GurshanRiarh/INSTRUMENTED-INFANT-CHILD-CAR-SEAT/docs/system-architecture.pdf

## Instrumented Infant-Child Car Seat - Data Path

Research prototype. V1 is the thesis reproduction; V3 is the modular sensor upgrade.

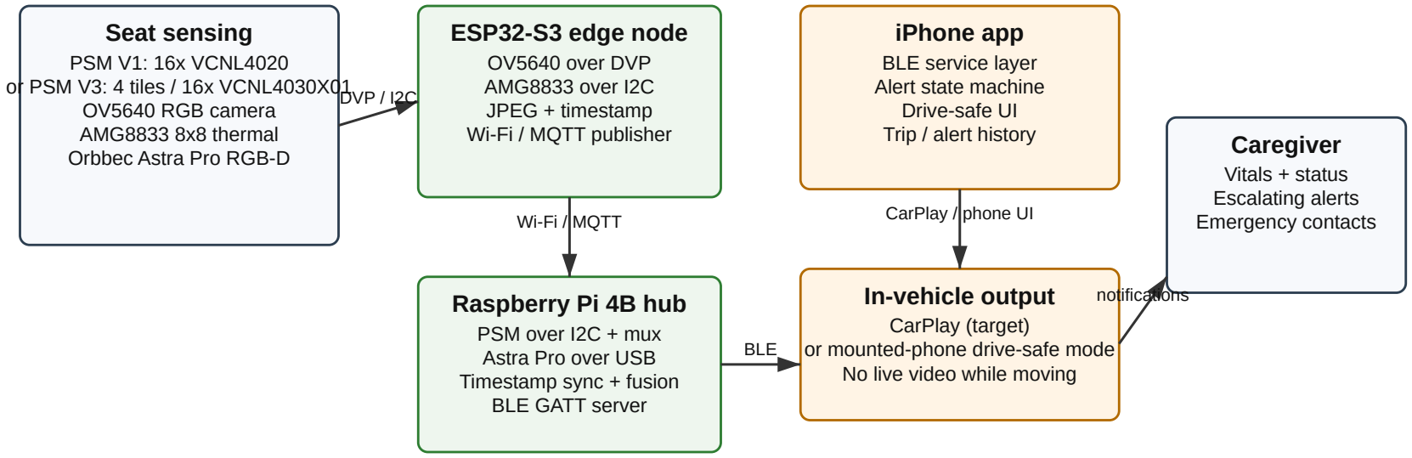
[picture p8: figure]
Seat sensing PSM V1: 16x VCNL4020 or PSM V3: 4 tiles / 16x VCNL4030X01 OV5640 RGB camera AMG8833 8x8 thermal Orbbec Astra Pro RGB-D; ESP32-S3 edge node OV5640 over DVP AMG8833 over I2C JPEG + timestamp Wi-Fi / MQTT publisher; Raspberry Pi 4B hub PSM over I2C + mux Astra Pro over USB Timestamp sync + fusion BLE GATT server; iPhone app BLE service layer Alert state machine Drive-safe UI Trip / alert history; In-vehicle output CarPlay (target) or mounted-phone drive-safe mode No live video while moving; Caregiver Vitals + status Escalating alerts Emergency contacts; DVP / I2C; Wi-Fi / MQTT; BLE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

### Design note

The Pi owns acquisition and fusion. The phone owns the alert state machine and escalation. The PSM is not a certified medical device. V1 uses two PCA9548A muxes (0x70/0x71) for 16 VCNL4020 sensors. V3 uses one PCA9548A (0x70) for up to 8 tiles.
