GurshanRiarh/INSTRUMENTED-INFANT-CHILD-CAR-SEAT/docs/psm-v1-architecture.pdf

## PSM V1 - Electrical Architecture (thesis baseline)

16x Vishay VCNL4020 (fixed 7-bit address 0x13), 2x PCA9548A 8-channel I2C switch, Tiva/LaunchPad header.

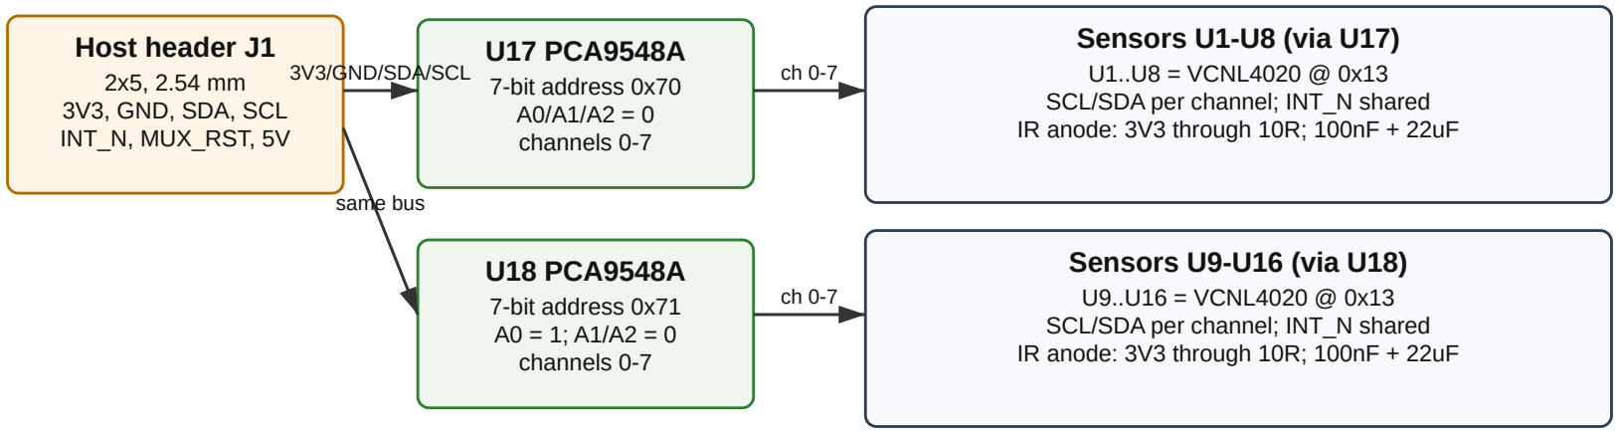
[picture p9: figure]
Host header J1 2x5, 2.54 mm 3V3, GND, SDA, SCL INT_N, MUX_RST, 5V; U17 PCA9548A 7-bit address 0x70 A0/A1/A2 = 0 channels 0-7; U18 PCA9548A 7-bit address 0x71 A0 = 1; A1/A2 = 0 channels 0-7; Sensors U1-U8 (via U17) U1..U8 = VCNL4020 @ 0x13 SCL/SDA per channel; INT_N shared IR anode: 3V3 through 10R; 100nF + 22uF; Sensors U9-U16 (via U18) U9..U16 = VCNL4020 @ 0x13 SCL/SDA per channel; INT_N shared IR anode: 3V3 through 10R; 100nF + 22uF; 3V3/GND/SDA/SCL; same bus

### Channel map

U17 ch0..7 -> U1..U8 U18 ch0..7 -> U9..U16
Each VCNL4020: 1 IR anode, 2 SDA, 3 INT, 4 SCL, 5 VDD, 8/9 GND, 6/7/10 NC.
Pull-ups: 4.7k on upstream SDA/SCL; 10k on MUX_RST and INT_N. 22uF bulk + 100nF per sensor. Board: 101.6 x 101.6 mm, 4x4 grid at 25.4 mm pitch, 0.2 mm polyimide flex, 2 layers.
