GurshanRiarh/INSTRUMENTED-INFANT-CHILD-CAR-SEAT/docs/psm-v3-topology.pdf

## PSM V3 - Modular Tile Topology (Prannav improvements)

One mux, four 2x2 tiles, four factory I2C addresses per tile. Expandable to 8 tiles / 32 sensors.

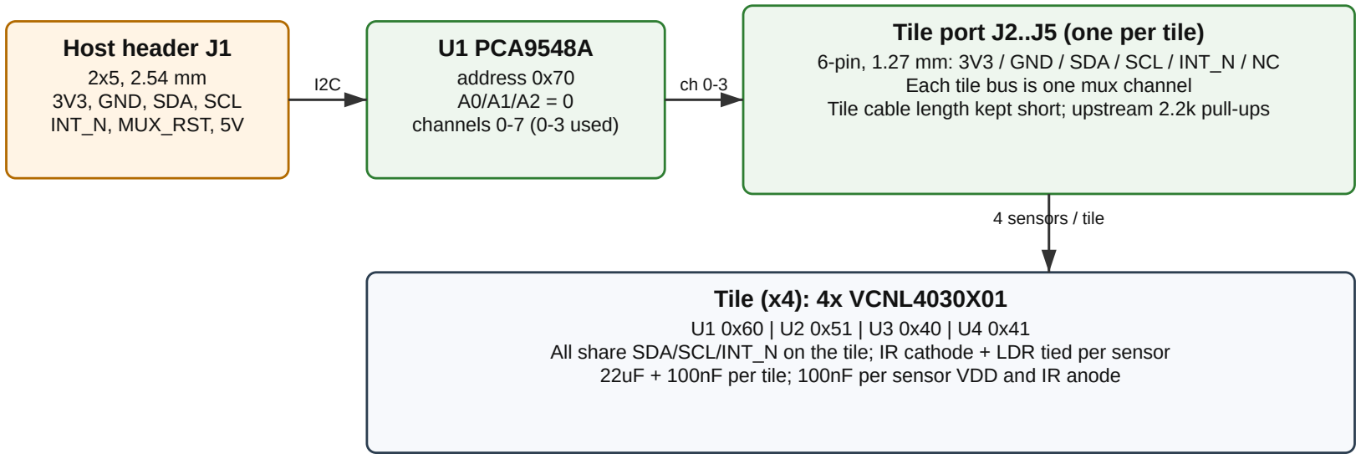
[picture p10: figure]
Host header J1 2x5, 2.54 mm 3V3, GND, SDA, SCL INT_N, MUX_RST, 5V; U1 PCA9548A address 0x70 A0/A1/A2 = 0 channels 0-7 (0-3 used); Tile port J2..J5 (one per tile); Each tile bus is one mux channel; Tile (x4): 4x VCNL4030X01 U1 0x60 | U2 0x51 | U3 0x40 | U4 0x41; 4 sensors / tile

6-pin, 1.27 mm: 3V3 / GND / SDA / SCL / INT_N / NC

Tile cable length kept short; upstream 2.2k pull-ups

All share SDA/SCL/INT_N on the tile; IR cathode + LDR tied per sensor 22uF + 100nF per tile; 100nF per sensor VDD and IR anode

### Why this is an improvement

V1: 2 muxes, 16 channels, fixed 0x13 sensors. V3: 1 mux, 4 channels, four addresses per tile. Tiles can be placed on the car-seat contour and replaced individually; the hub supports up to 8 tiles. Tile: 30 x 30 mm, 0.2 mm flex, sealing ring + conformal coat. Hub: 60 x 40 mm, 1.6 mm FR4.
