GurshanRiarh/INSTRUMENTED-INFANT-CHILD-CAR-SEAT/docs/psm-v1-architecture.png

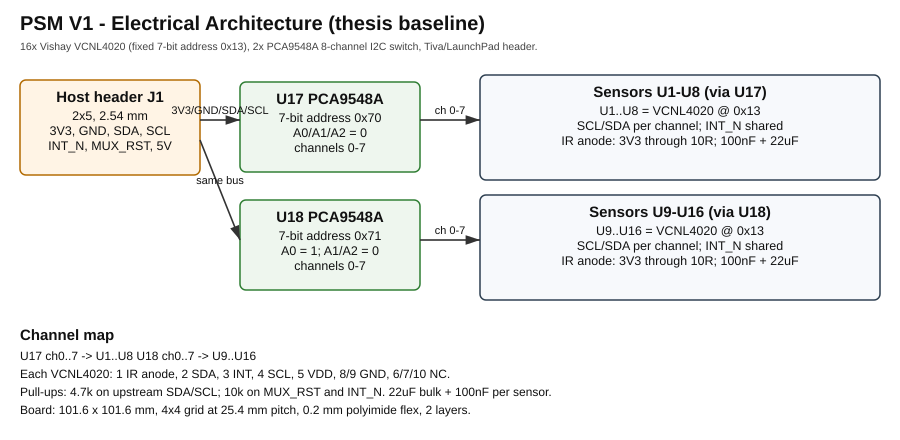
docs/psm-v1-architecture.png
