GurshanRiarh/INSTRUMENTED-INFANT-CHILD-CAR-SEAT/docs/psm-v1-schematic.png

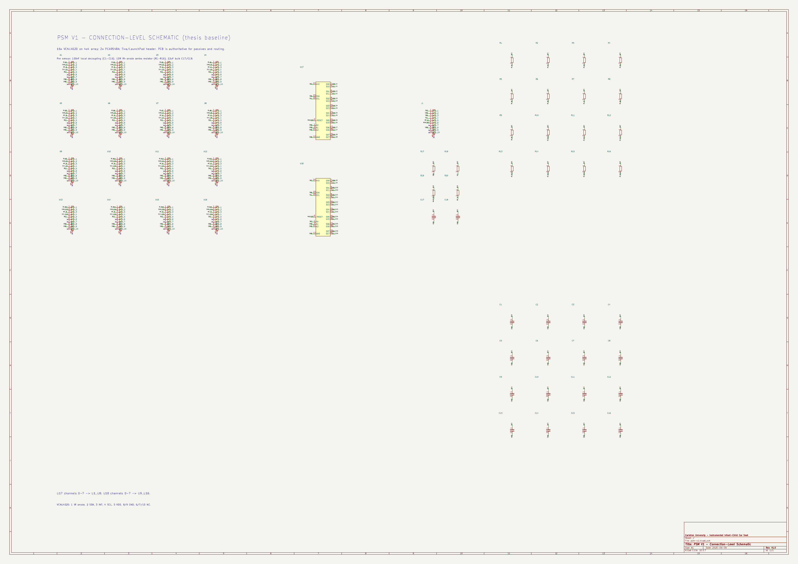
docs/psm-v1-schematic.png
