GurshanRiarh/INSTRUMENTED-INFANT-CHILD-CAR-SEAT/hardware/psm-v3/tile/bom.csv

Quantity | References | Value | Footprint
8 | C1 C2 C3 C4 C5 C6 C7 C8 | 100n | C_0603_1608Metric
3 | R1 R2 R3 | 10k | R_0603_1608Metric
1 | C9 | 22u | C_0805_2012Metric
4 | H1 H2 H3 H4 | M2 | MountingHole_2.2mm_M2
1 | J1 | TILE_IF | PinHeader_1x06_P1.27mm_Vertical
1 | U3 | VCNL4030X01 0x40 | VCNL4030X01
1 | U4 | VCNL4030X01 0x41 | VCNL4030X01
1 | U2 | VCNL4030X01 0x51 | VCNL4030X01
1 | U1 | VCNL4030X01 0x60 | VCNL4030X01
