GurshanRiarh/INSTRUMENTED-INFANT-CHILD-CAR-SEAT/docs/psm-v1-schematic.pdf

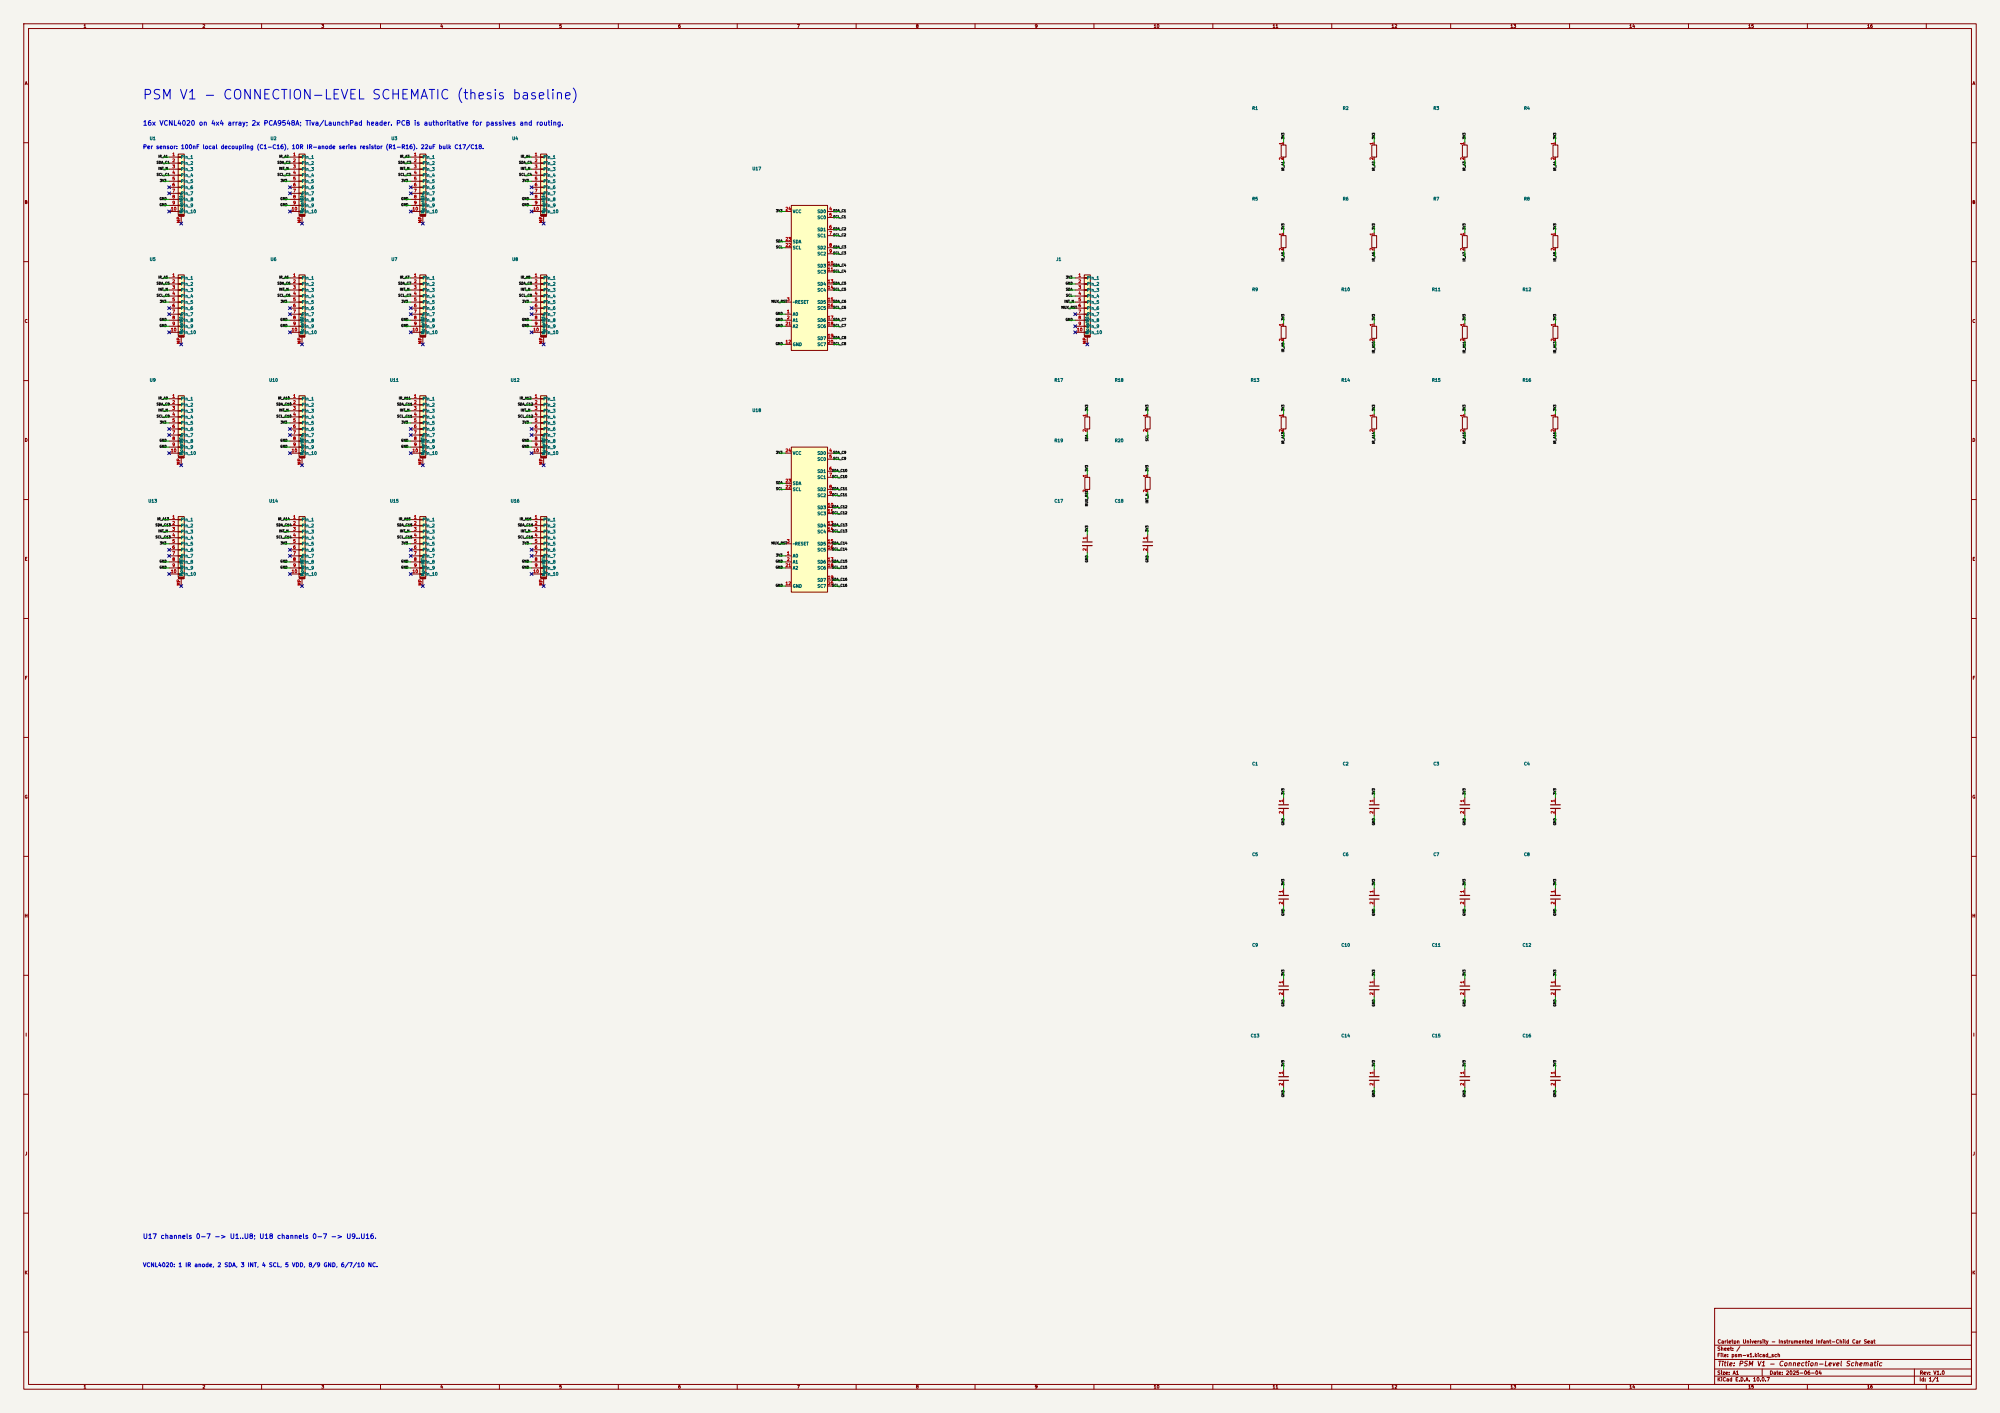
[picture p13: page 1]

PSM V1 - CONNECTION-LEVEL SCHEMATIC (thesis baseline)

16x VCNL4020 on 4x4 array; 2x PCA9548A; Tiva/LaunchPad header. PCB is authoritative for passives and routing.

Per sensor: 100nF local decoupling (C1-C16), 10R IR-anode series resistor (R1-R16). 22uF bulk C17/C18.

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

Carleton University - Instrumented Infant-Child Car Seat
Sheet: /
File: psm-v1.kicad_sch
Title: PSM V1 - Connection-Level Schematic

Size: A1 | Rev: V1.0
KiCad E.D.A. 10.0.7 | Id: 1/1
