GurshanRiarh/INSTRUMENTED-INFANT-CHILD-CAR-SEAT/docs/psm-v3-hub-schematic.pdf

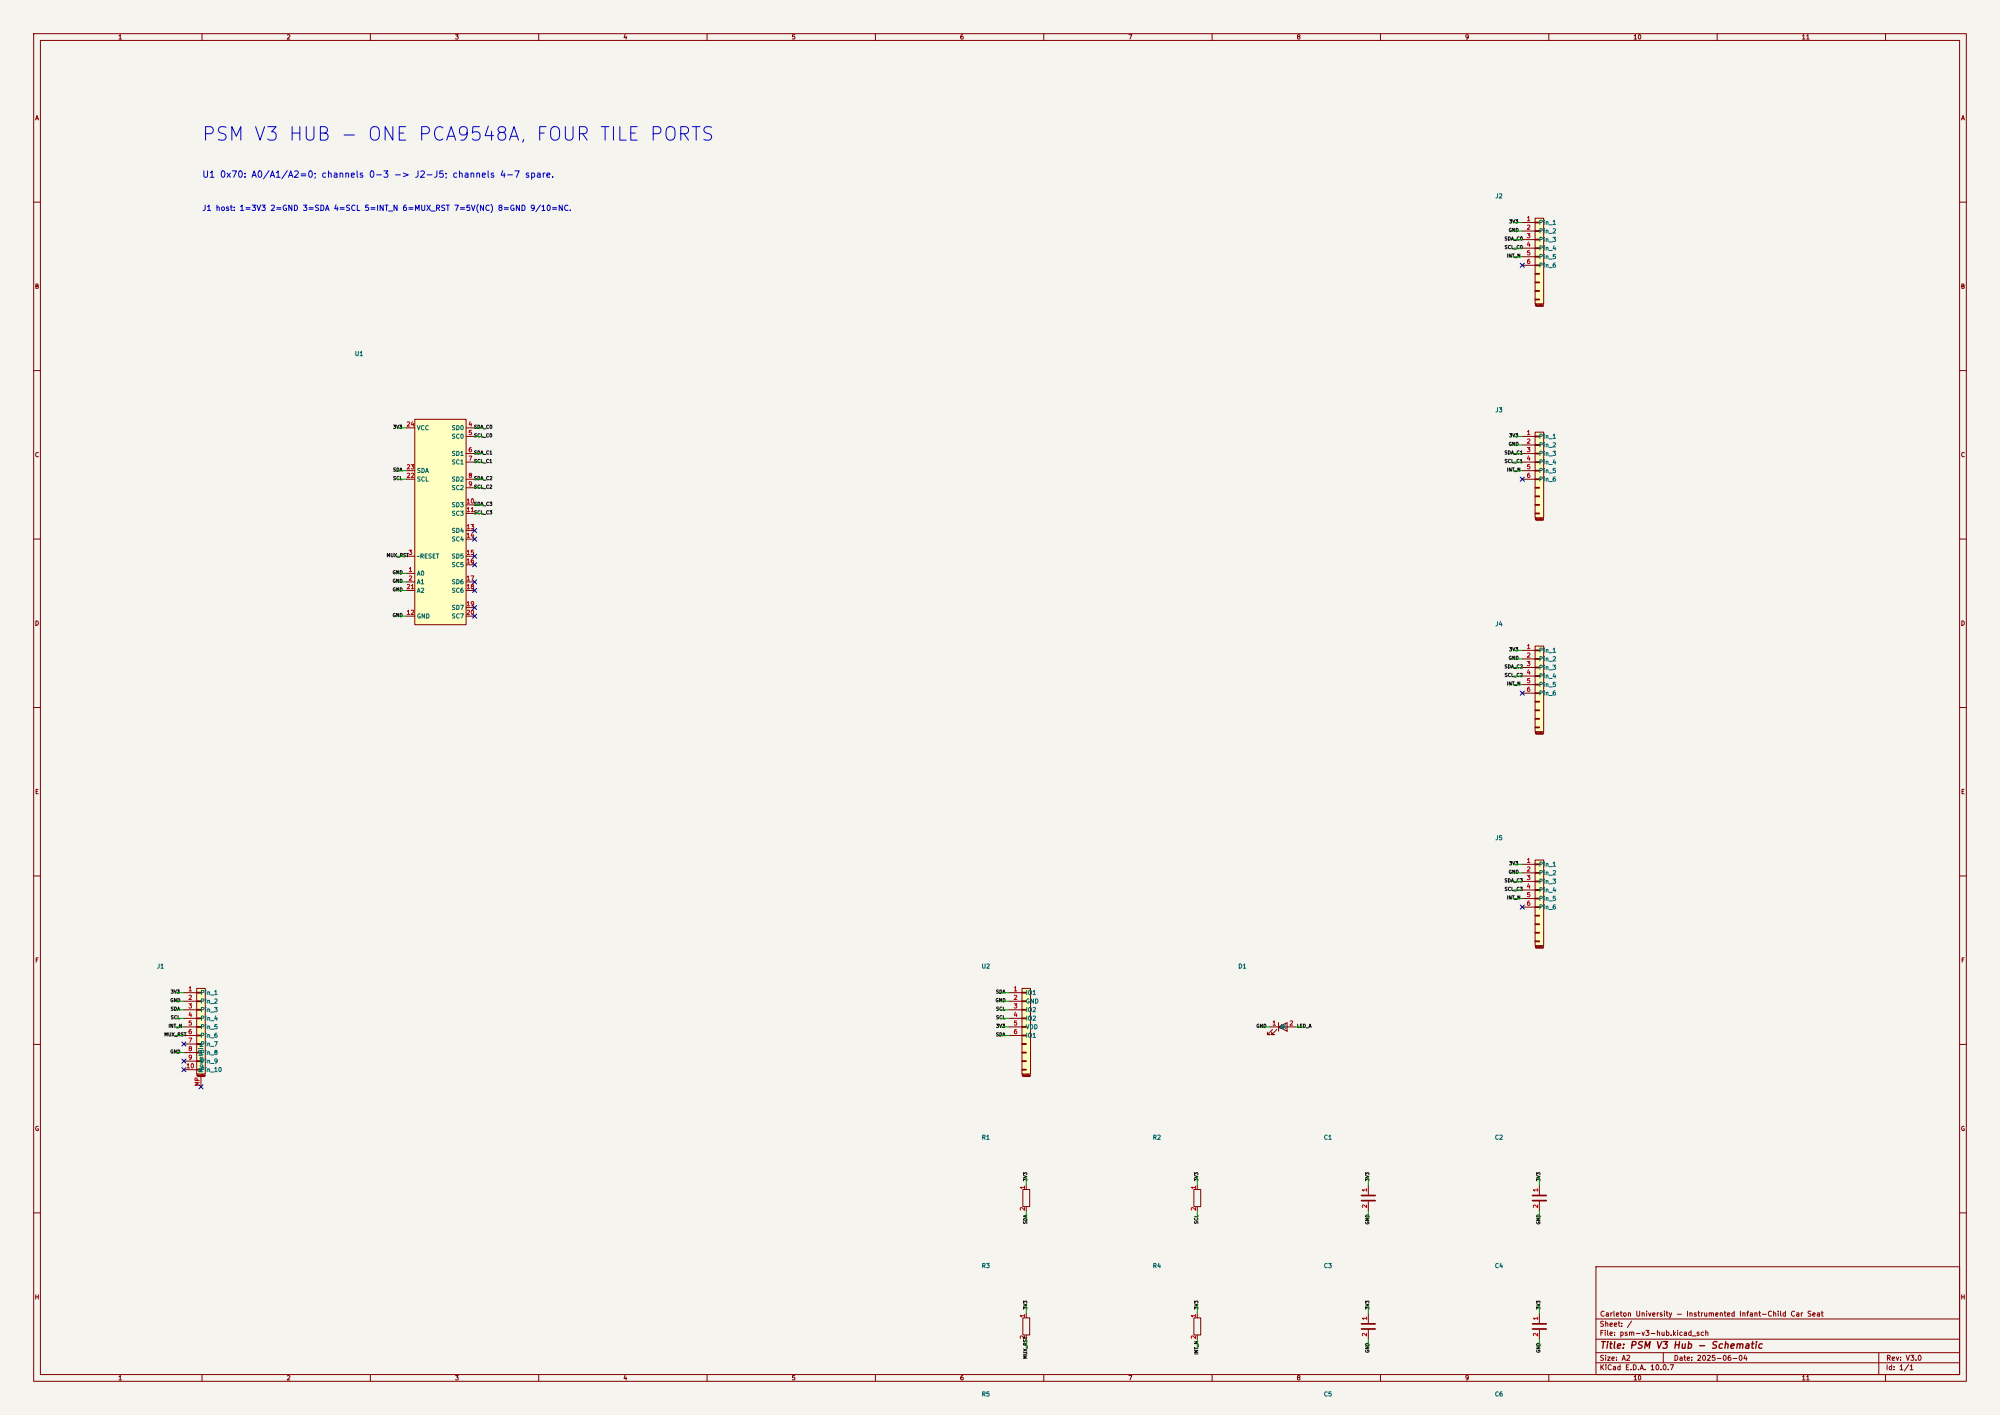
[picture p14: page 1]

PSM V3 HUB - ONE PCA9548A, FOUR TILE PORTS

J1 host: 1=3V3 2=GND 3=SDA 4=SCL 5=INT_N 6=MUX_RST 7=5V(NC) 8=GND 9/10=NC.

Carleton University - Instrumented Infant-Child Car Seat 1 2 C5

Sheet: /
File: psm-v3-hub.kicad_sch
Title: PSM V3 Hub - Schematic

Size: A2 | Rev: V3.0
KiCad E.D.A. 10.0.7 | Id: 1/1
