GurshanRiarh/INSTRUMENTED-INFANT-CHILD-CAR-SEAT/docs/psm-v3-tile-schematic.pdf

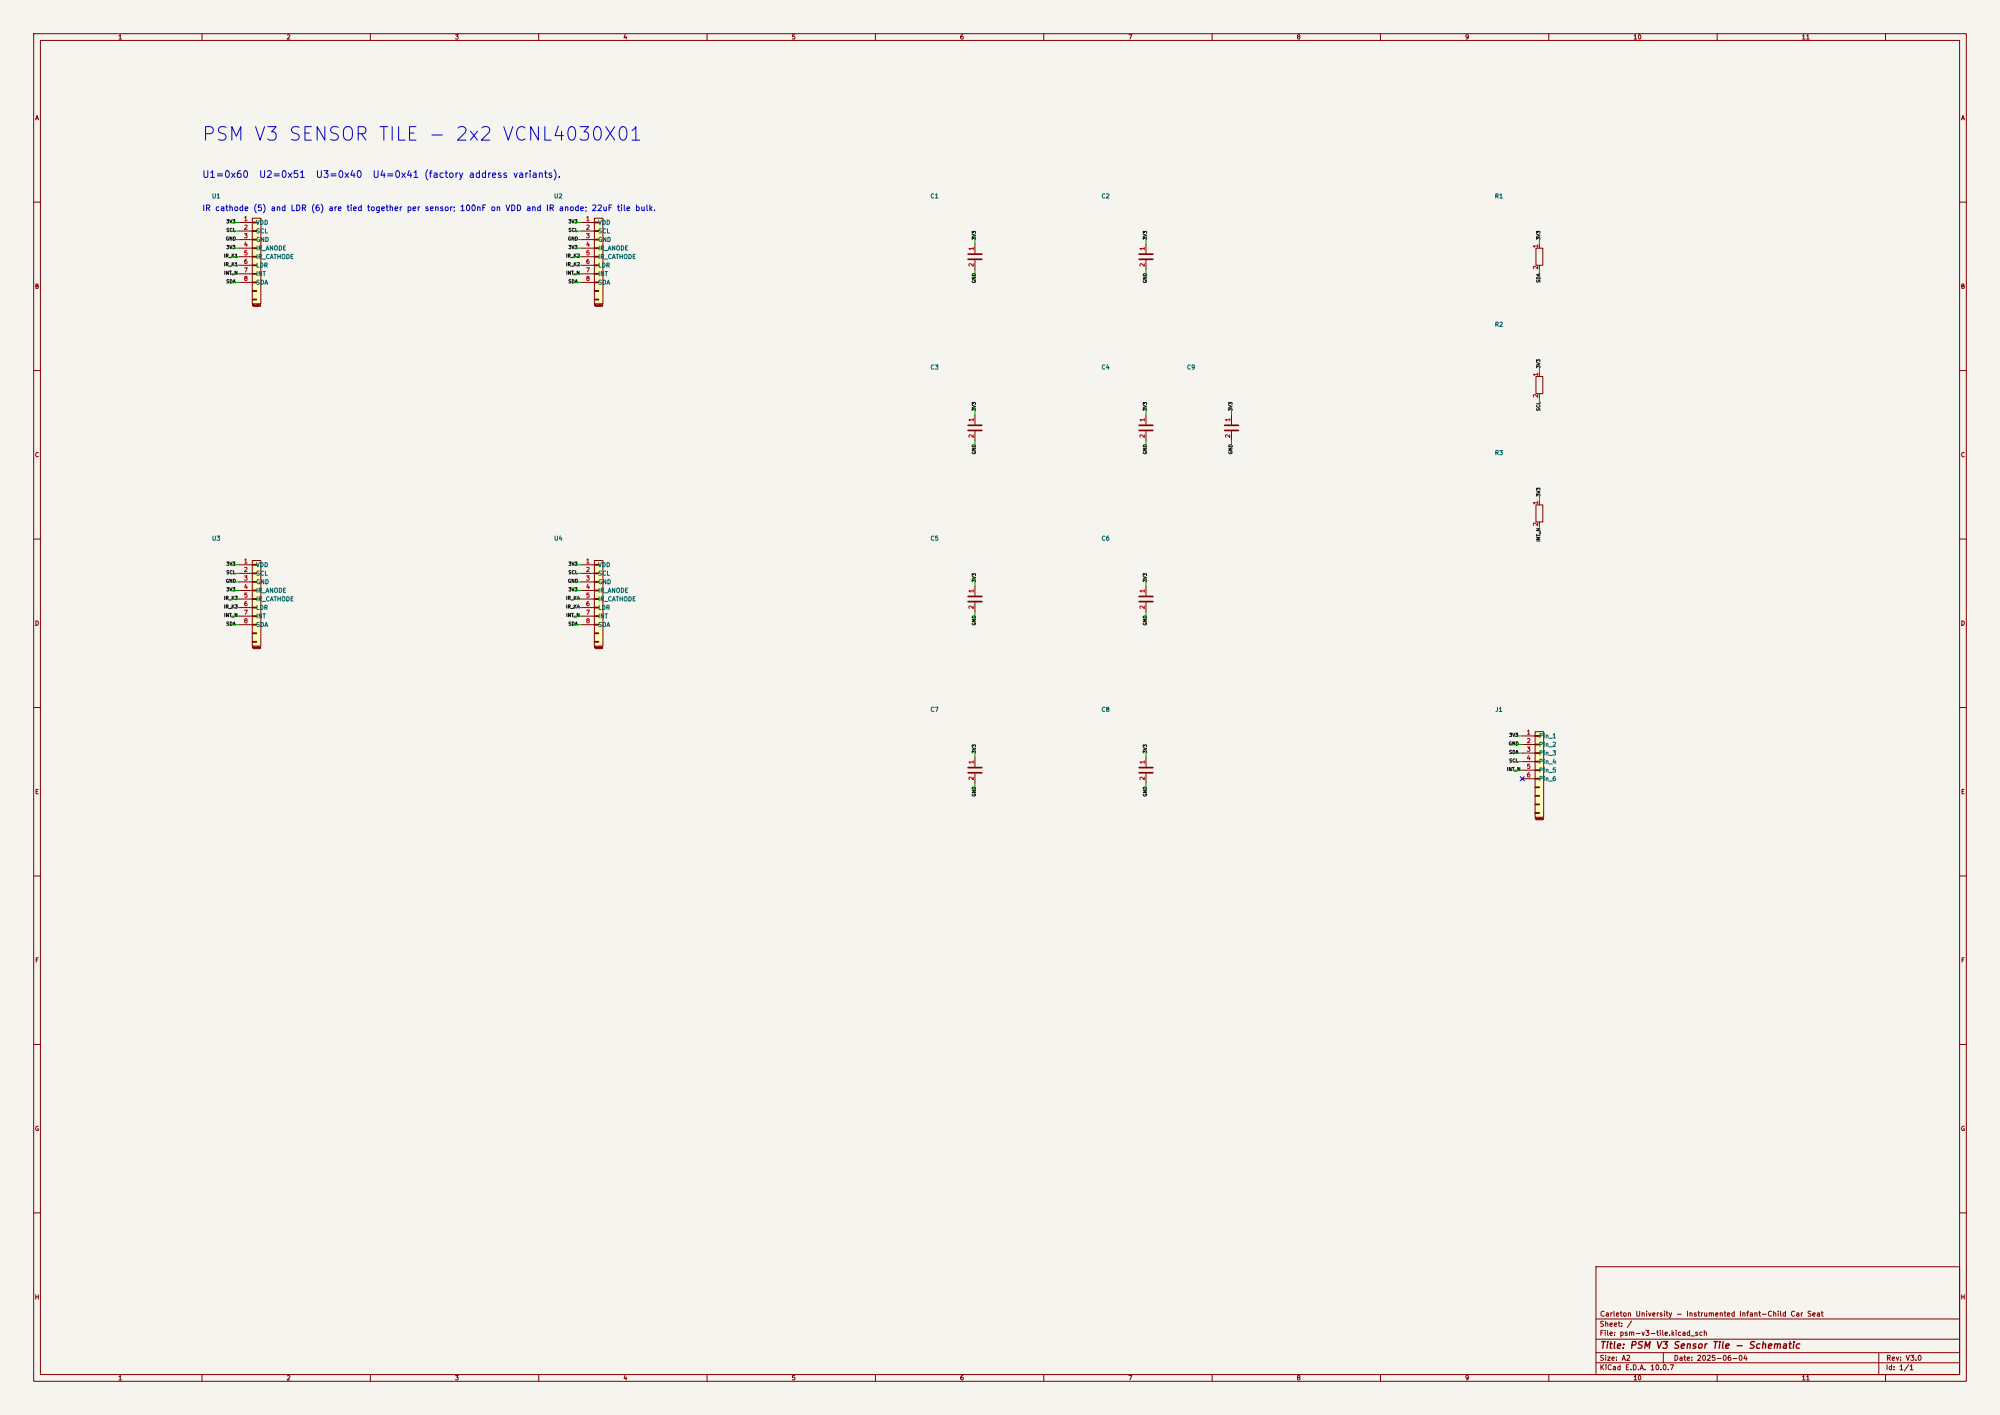
[picture p15: page 1]

SDA PSM V3 SENSOR TILE - 2x2 VCNL4030X01

SDA 8 U1
IR cathode (5) and LDR (6) are tied together per sensor; 100nF on VDD and IR anode; 22uF tile bulk.

Carleton University - Instrumented Infant-Child Car Seat
Sheet: /
File: psm-v3-tile.kicad_sch
Title: PSM V3 Sensor Tile - Schematic

Size: A2 | Rev: V3.0
KiCad E.D.A. 10.0.7 | Id: 1/1
