GurshanRiarh/INSTRUMENTED-INFANT-CHILD-CAR-SEAT/hardware/psm-v3/hub/fab/psm-v3-hub.pdf

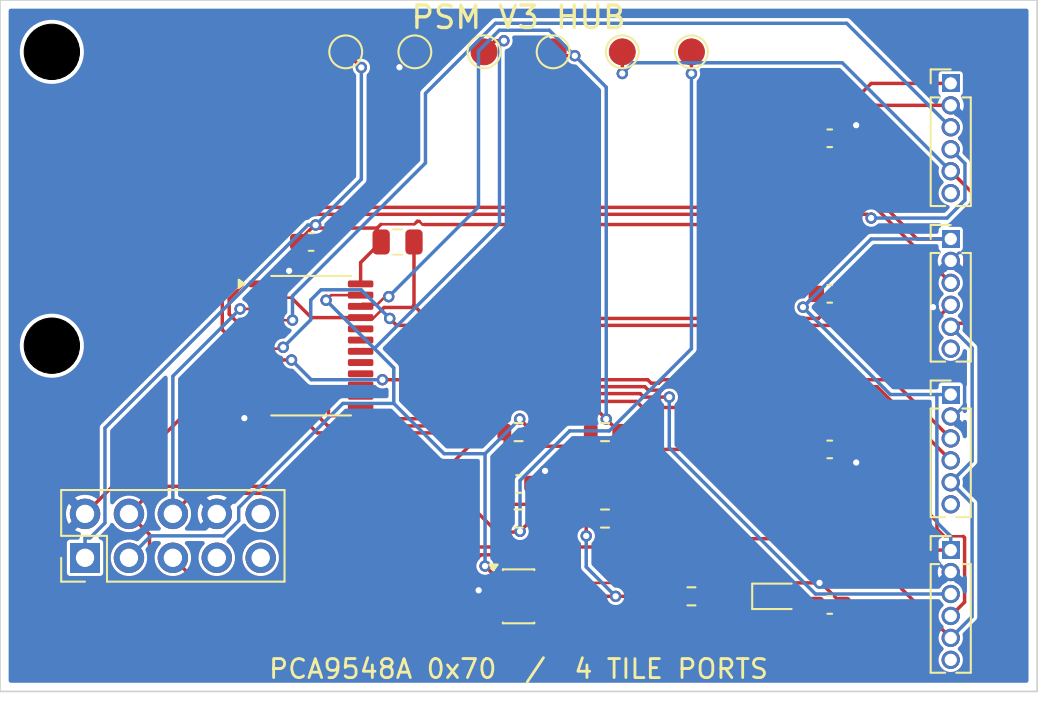
[picture p16: page 1]

PCA9548A 0x70 / 4 TILE PORTS PSM V3 HUB
