GurshanRiarh/INSTRUMENTED-INFANT-CHILD-CAR-SEAT/hardware/psm-v3/tile/fab/psm-v3-tile.pdf

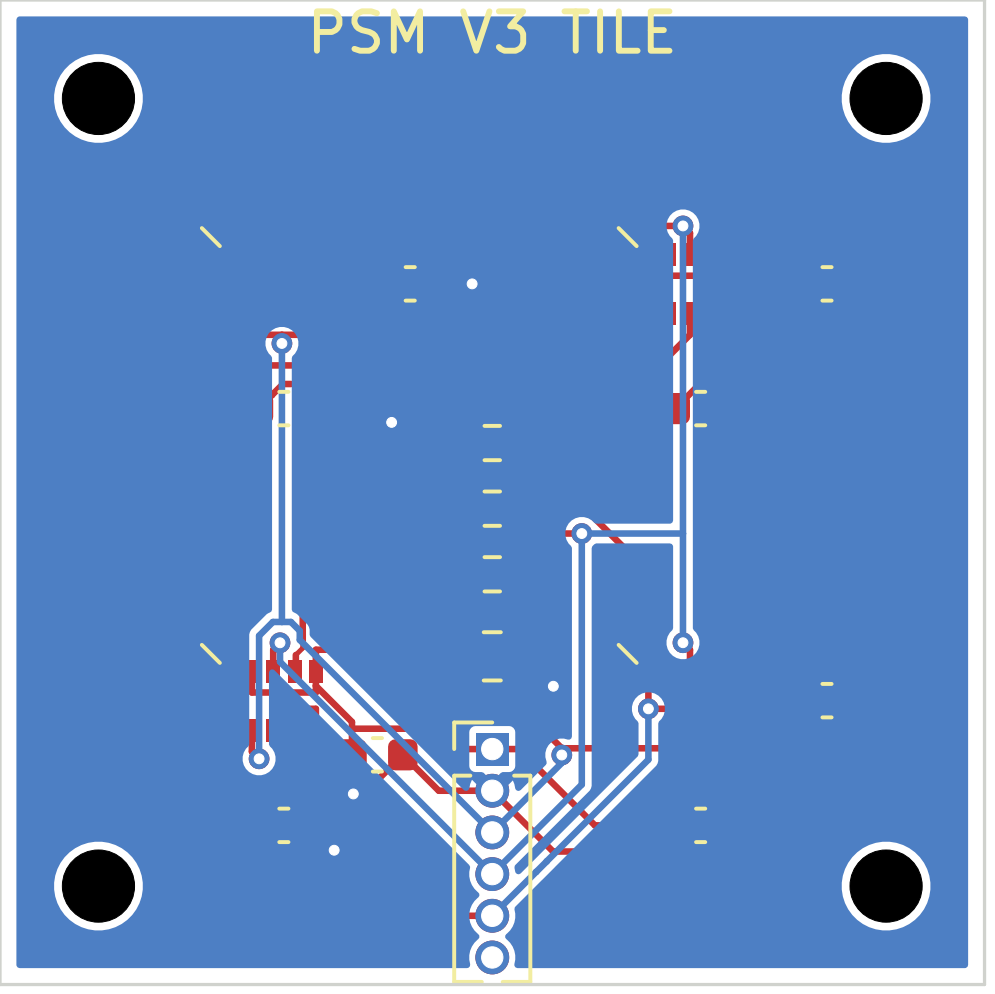
[picture p17: page 1]
