GurshanRiarh/INSTRUMENTED-INFANT-CHILD-CAR-SEAT/hardware/psm-v1/fab/psm-v1.pdf

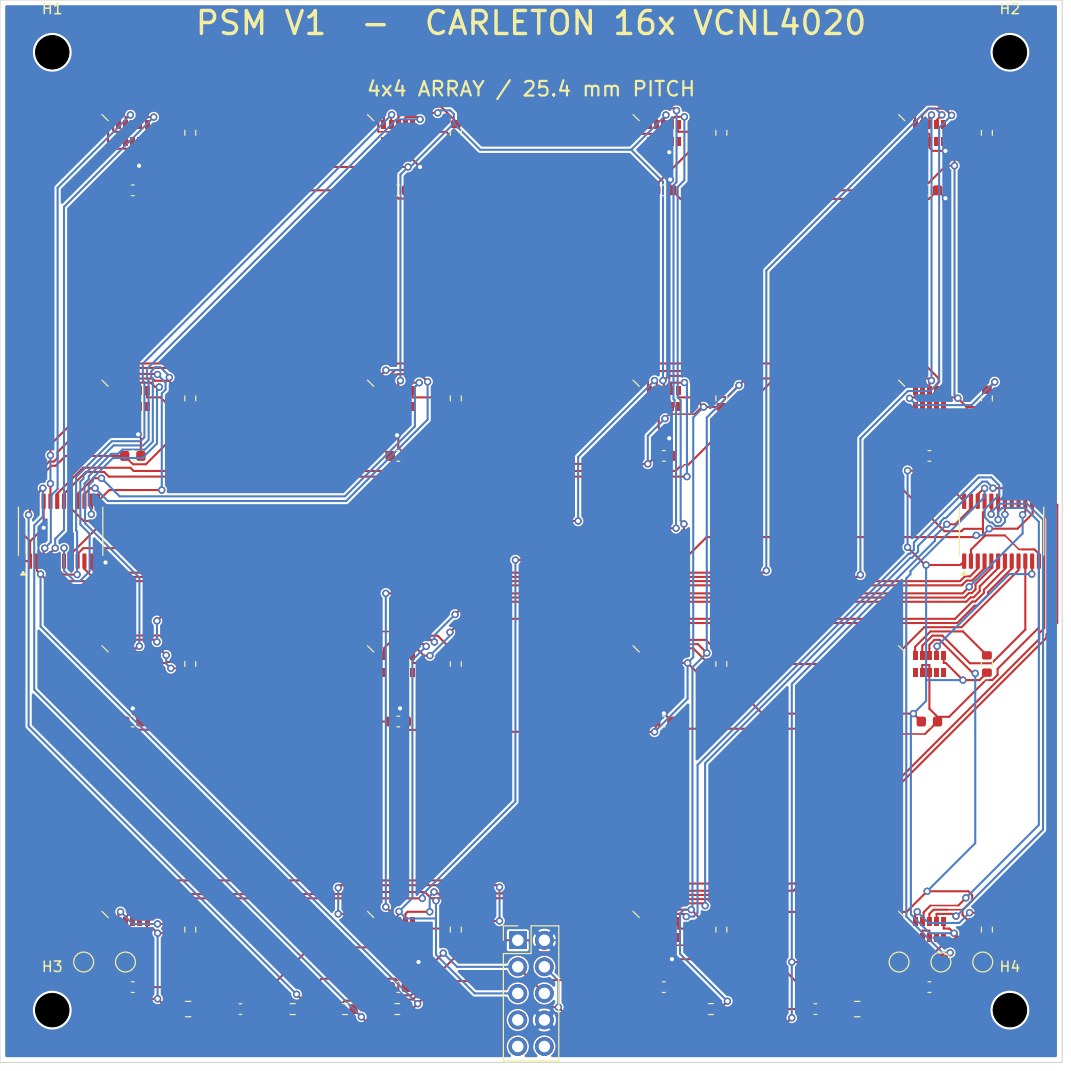
[picture p18: page 1]
