GurshanRiarh/INSTRUMENTED-INFANT-CHILD-CAR-SEAT/hardware/psm-v1/psm-v1.kicad_pcb

## KiCad design hardware/psm-v1/psm-v1.kicad_pcb (2026-10-25, an earlier design)

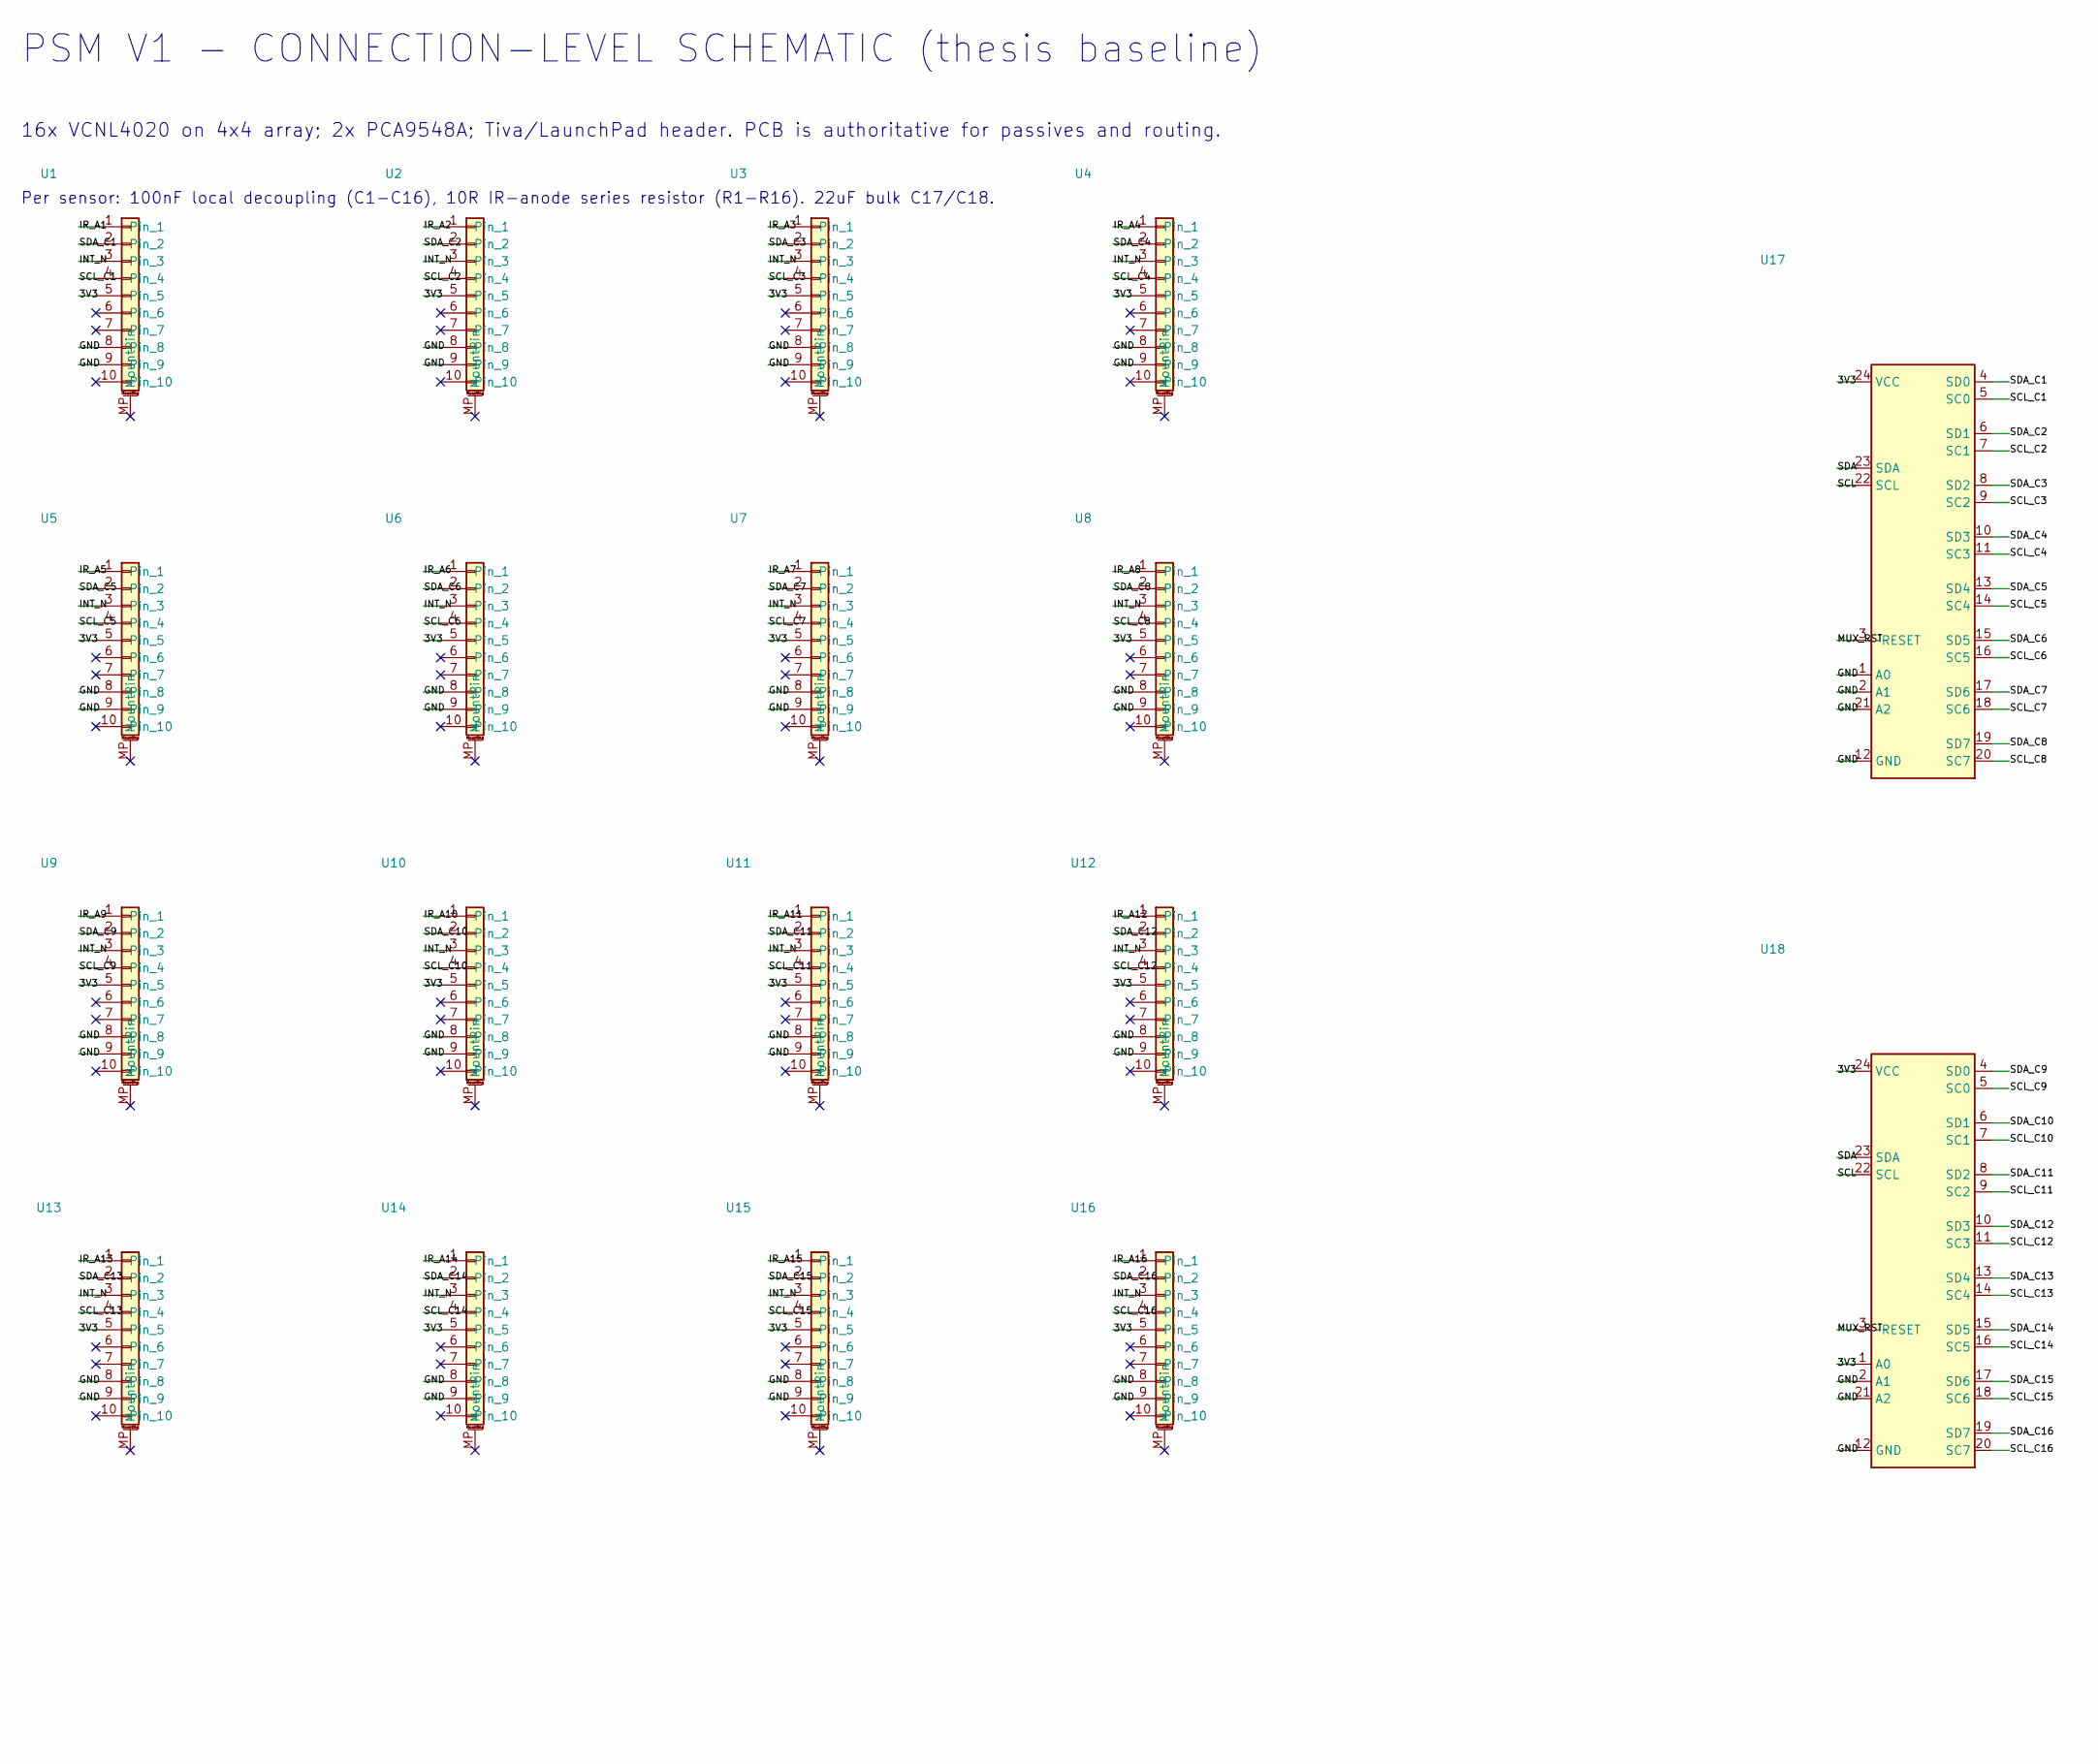
[picture p19: schematic psm-v1.kicad_sch, PSM V1 - Connection-Level Schematic, part in row 1, column 1]

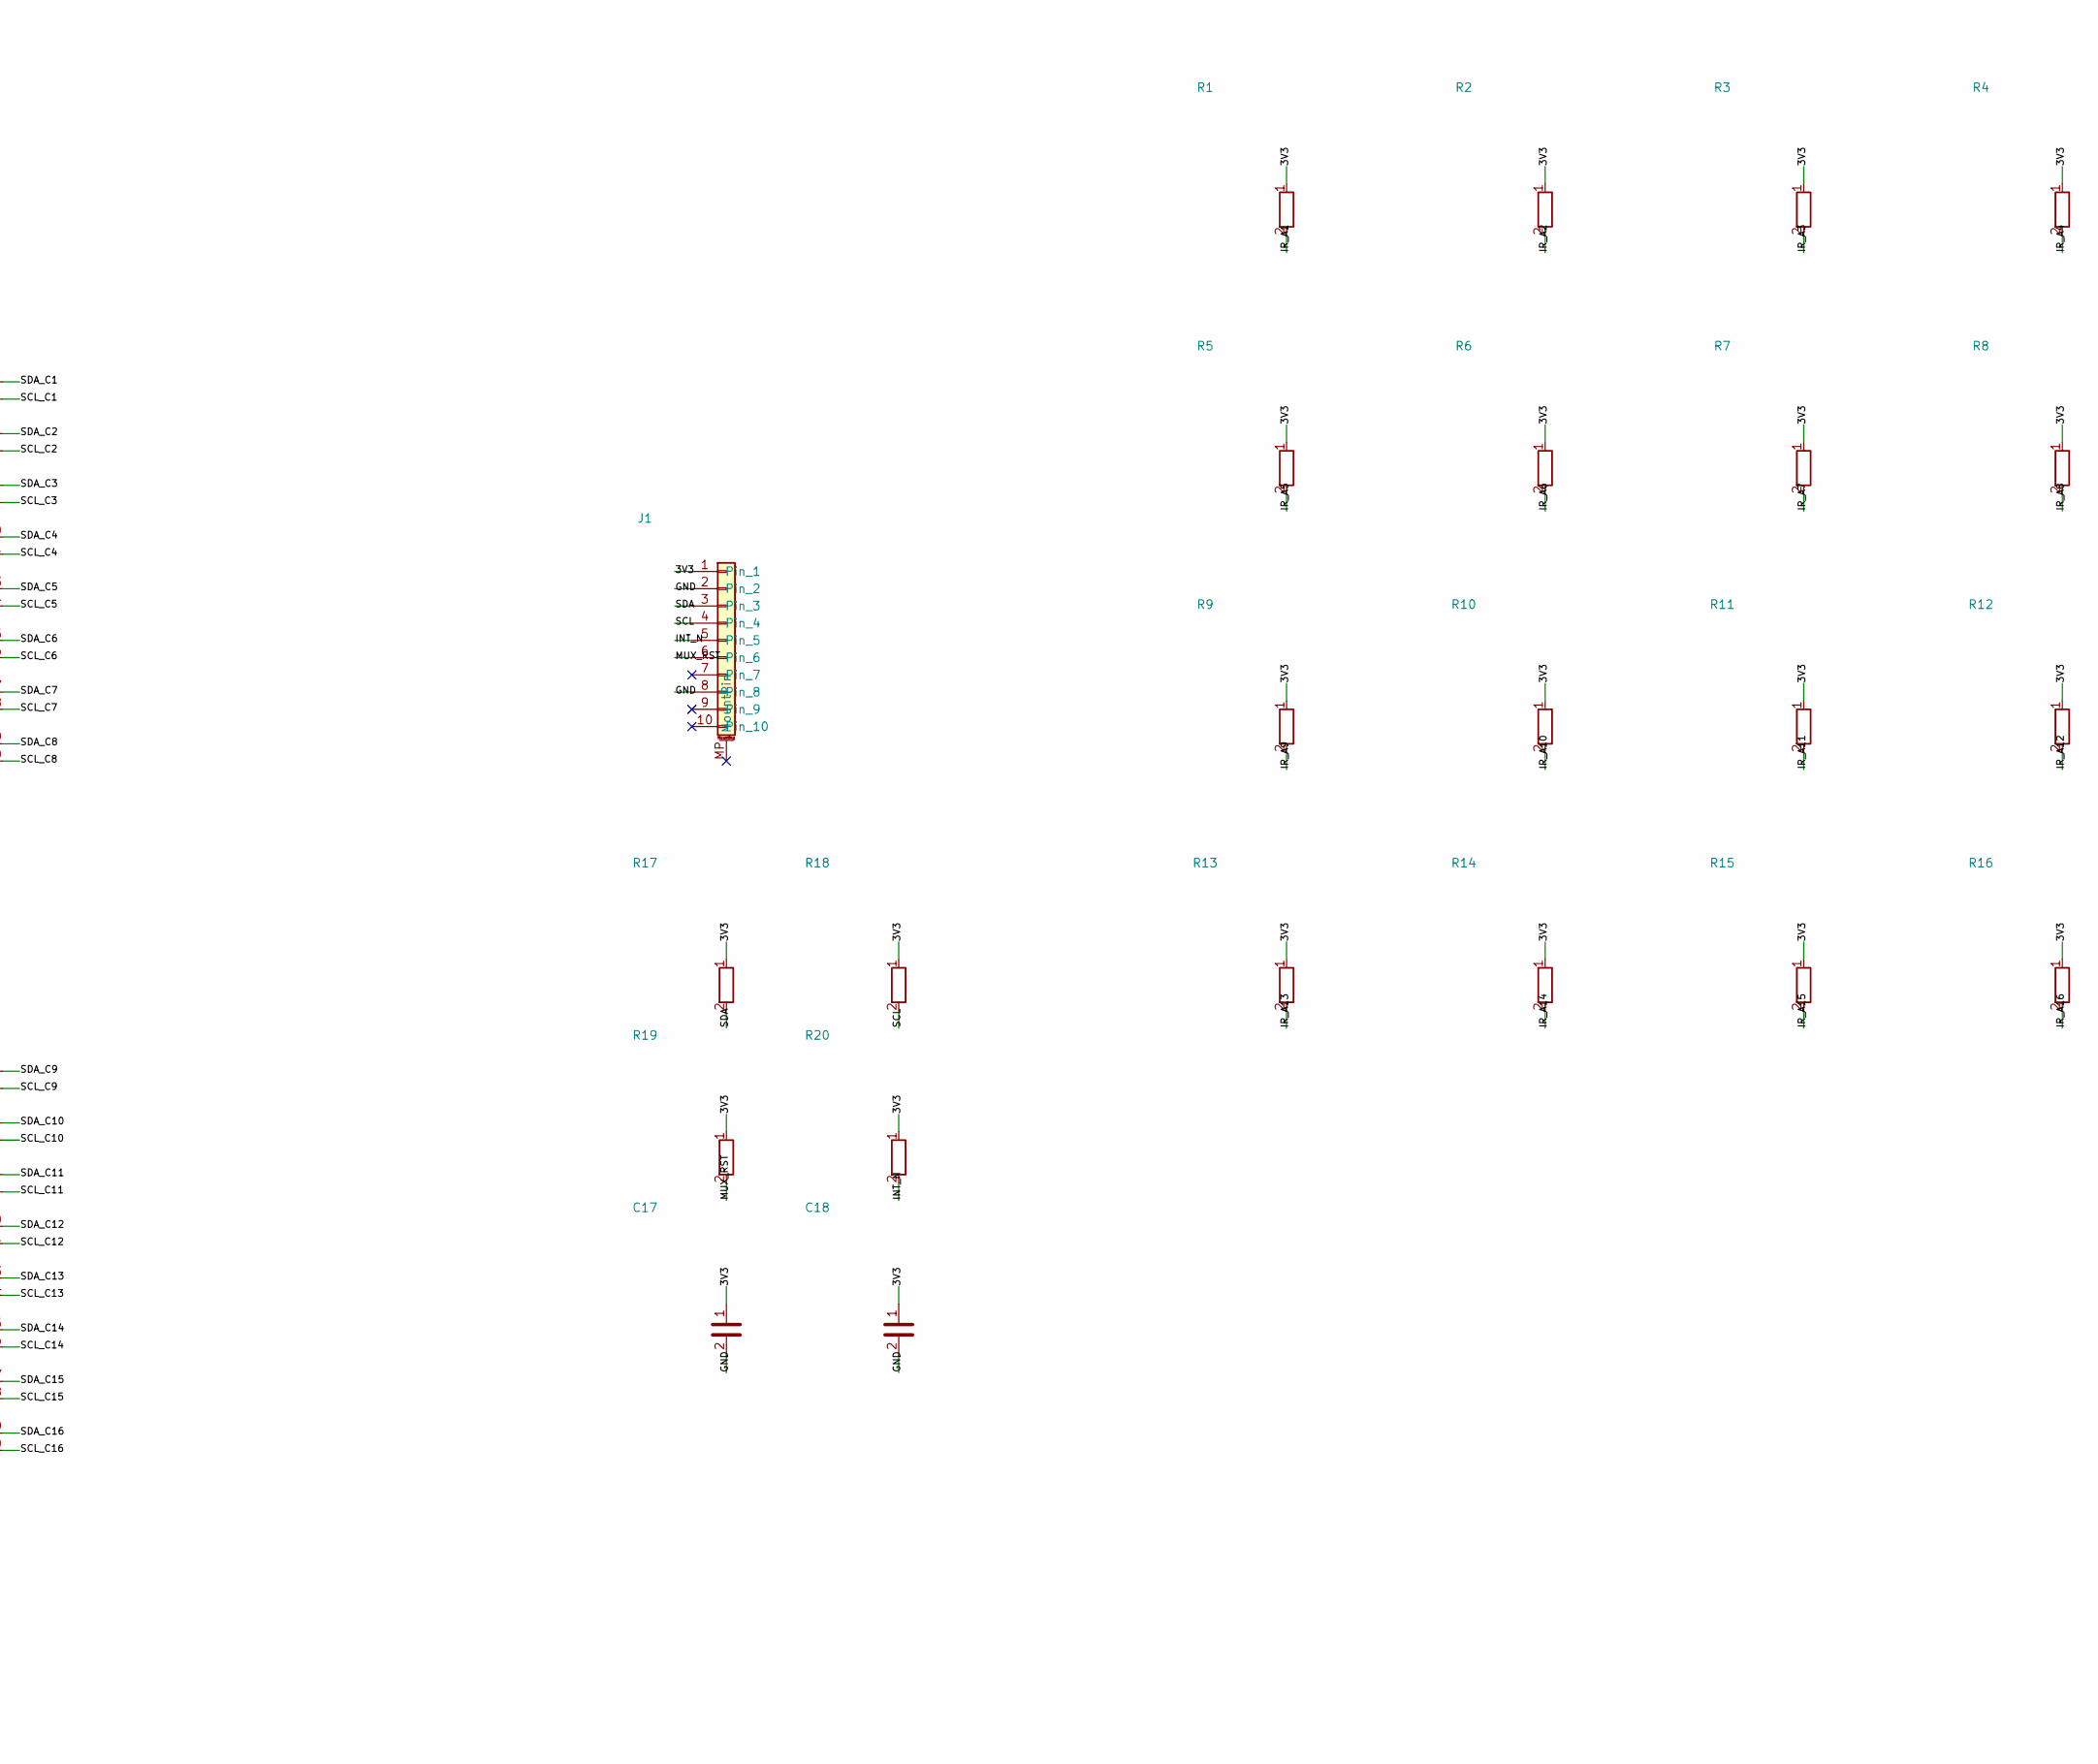
[picture p20: schematic psm-v1.kicad_sch, PSM V1 - Connection-Level Schematic, part in row 1, column 2]

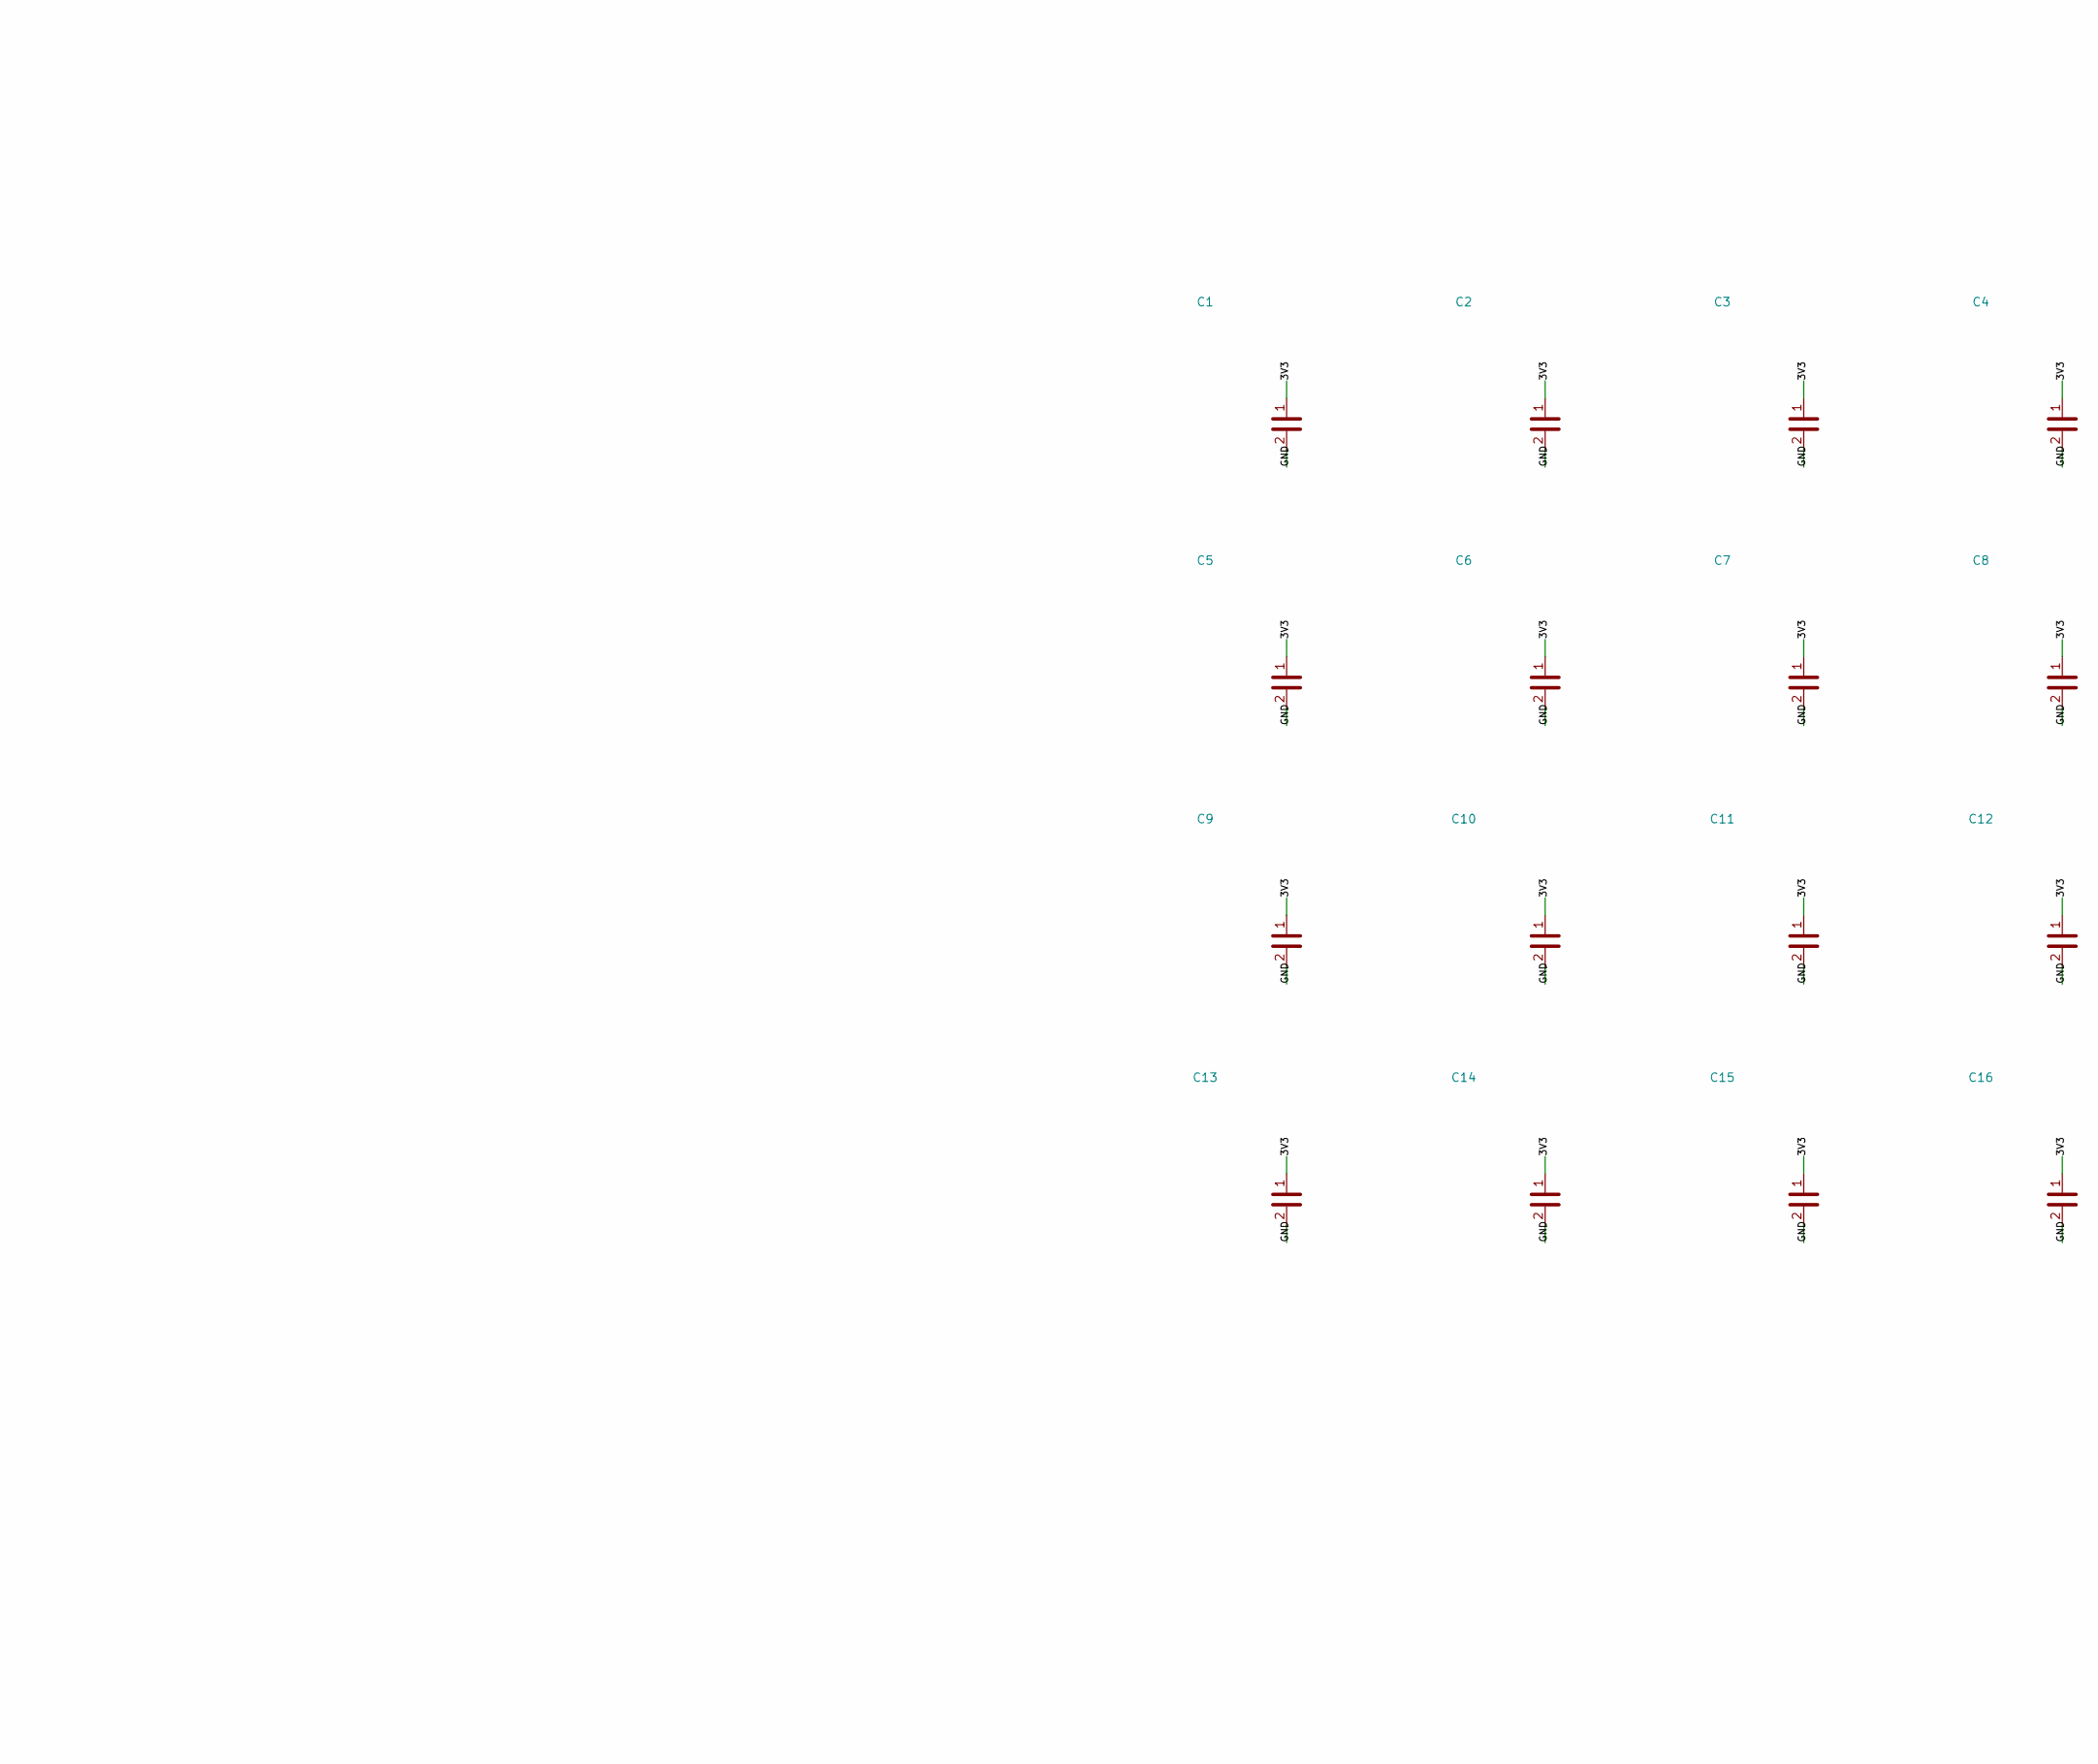
[picture p21: schematic psm-v1.kicad_sch, PSM V1 - Connection-Level Schematic, part in row 2, column 2]

Parts:
C1, C2, C3, C4, C5, C6, C7, C8, C9, C10, C11, C12, C13, C14, C15, C16: 100n; C_0603_1608Metric; Part Description 0.1uF 10% 16V Ceramic Capacitor X7R 040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
C17, C18: 22u; C_0603_1608Metric; Part Description 0.1uF 10% 16V Ceramic Capacitor X7R 040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
J1: HOST_IF; PinHeader_2x05_P2.54mm_Vertical
R1, R2, R3, R4, R5, R6, R7, R8, R9, R10, R11, R12, R13, R14, R15, R16: 10R; R_0603_1608Metric
R17, R18: 4.7k; R_0603_1608Metric
R19, R20: 10k; R_0603_1608Metric
U1, U2, U3, U4, U5, U6, U7, U8, U9, U10, U11, U12, U13, U14, U15, U16: VCNL4020
U17: PCA9548A 0x70; TSSOP-24_4.4x7.8mm_P0.65mm; MPN PI4MSD5V9548AZDEX
U18: PCA9548A 0x71; TSSOP-24_4.4x7.8mm_P0.65mm; MPN PI4MSD5V9548AZDEX

Connections:
3V3: C1.1, C2.1, C3.1, C4.1, C5.1, C6.1, C7.1, C8.1, C9.1, C10.1, C11.1, C12.1, C13.1, C14.1, C15.1, C16.1, C17.1, C18.1, J1.1, R1.1, R2.1, R3.1, R4.1, R5.1, R6.1, R7.1, R8.1, R9.1, R10.1, R11.1, R12.1, R13.1, R14.1, R15.1, R16.1, R17.1, R18.1, R19.1, R20.1, U1.5, U2.5, U3.5, U4.5, U5.5, U6.5, U7.5, U8.5, U9.5, U10.5, U11.5, U12.5, U13.5, U14.5, U15.5, U16.5, U17.24 (VCC), U18.1 (A0), U18.24 (VCC); also elsewhere on the board
GND: C1.2, C2.2, C3.2, C4.2, C5.2, C6.2, C7.2, C8.2, C9.2, C10.2, C11.2, C12.2, C13.2, C14.2, C15.2, C16.2, C17.2, C18.2, J1.2, J1.8, U1.8, U1.9, U2.8, U2.9, U3.8, U3.9, U4.8, U4.9, U5.8, U5.9, U6.8, U6.9, U7.8, U7.9, U8.8, U8.9, U9.8, U9.9, U10.8, U10.9, U11.8, U11.9, U12.8, U12.9, U13.8, U13.9, U14.8, U14.9, U15.8, U15.9, U16.8, U16.9, U17.1 (A0), U17.2 (A1), U17.12 (GND), U17.21 (A2), U18.2 (A1), U18.12 (GND), U18.21 (A2); also elsewhere on the board
INT_N: J1.5, R20.2, U1.3, U2.3, U3.3, U4.3, U5.3, U6.3, U7.3, U8.3, U9.3, U10.3, U11.3, U12.3, U13.3, U14.3, U15.3, U16.3; also elsewhere on the board
IR_A1: R1.2, U1.1
IR_A2: R2.2, U2.1
IR_A3: R3.2, U3.1
IR_A4: R4.2, U4.1
IR_A5: R5.2, U5.1
IR_A6: R6.2, U6.1
IR_A7: R7.2, U7.1
IR_A8: R8.2, U8.1
IR_A9: R9.2, U9.1
IR_A10: R10.2, U10.1
IR_A11: R11.2, U11.1
IR_A12: R12.2, U12.1
IR_A13: R13.2, U13.1
IR_A14: R14.2, U14.1
IR_A15: R15.2, U15.1
IR_A16: R16.2, U16.1
MUX_RST: J1.6, R19.2, U17.3 (~RESET), U18.3 (~RESET)
SCL: J1.4, R18.2, U17.22 (SCL), U18.22 (SCL); also elsewhere on the board
SCL_C1: U1.4, U17.5 (SC0)
SCL_C2: U2.4, U17.7 (SC1)
SCL_C3: U3.4, U17.9 (SC2)
SCL_C4: U4.4, U17.11 (SC3)
SCL_C5: U5.4, U17.14 (SC4)
SCL_C6: U6.4, U17.16 (SC5)
SCL_C7: U7.4, U17.18 (SC6)
SCL_C8: U8.4, U17.20 (SC7)
SCL_C9: U9.4, U18.5 (SC0)
SCL_C10: U10.4, U18.7 (SC1)
SCL_C11: U11.4, U18.9 (SC2)
SCL_C12: U12.4, U18.11 (SC3)
SCL_C13: U13.4, U18.14 (SC4)
SCL_C14: U14.4, U18.16 (SC5)
SCL_C15: U15.4, U18.18 (SC6)
SCL_C16: U16.4, U18.20 (SC7)
SDA: J1.3, R17.2, U17.23 (SDA), U18.23 (SDA); also elsewhere on the board
SDA_C1: U1.2, U17.4 (SD0)
SDA_C2: U2.2, U17.6 (SD1)
SDA_C3: U3.2, U17.8 (SD2)
SDA_C4: U4.2, U17.10 (SD3)
SDA_C5: U5.2, U17.13 (SD4)
SDA_C6: U6.2, U17.15 (SD5)
SDA_C7: U7.2, U17.17 (SD6)
SDA_C8: U8.2, U17.19 (SD7)
SDA_C9: U9.2, U18.4 (SD0)
SDA_C10: U10.2, U18.6 (SD1)
SDA_C11: U11.2, U18.8 (SD2)
SDA_C12: U12.2, U18.10 (SD3)
SDA_C13: U13.2, U18.13 (SD4)
SDA_C14: U14.2, U18.15 (SD5)
SDA_C15: U15.2, U18.17 (SD6)
SDA_C16: U16.2, U18.19 (SD7)

Notes on the sheet:
PSM V1 - CONNECTION-LEVEL SCHEMATIC (thesis baseline)
16x VCNL4020 on 4x4 array; 2x PCA9548A; Tiva/LaunchPad header. PCB is authoritative for passives and routing.
Per sensor: 100nF local decoupling (C1-C16), 10R IR-anode series resistor (R1-R16). 22uF bulk C17/C18.
U17 channels 0-7 -> U1..U8; U18 channels 0-7 -> U9..U16.
VCNL4020: 1 IR anode, 2 SDA, 3 INT, 4 SCL, 5 VDD, 8/9 GND, 6/7/10 NC.

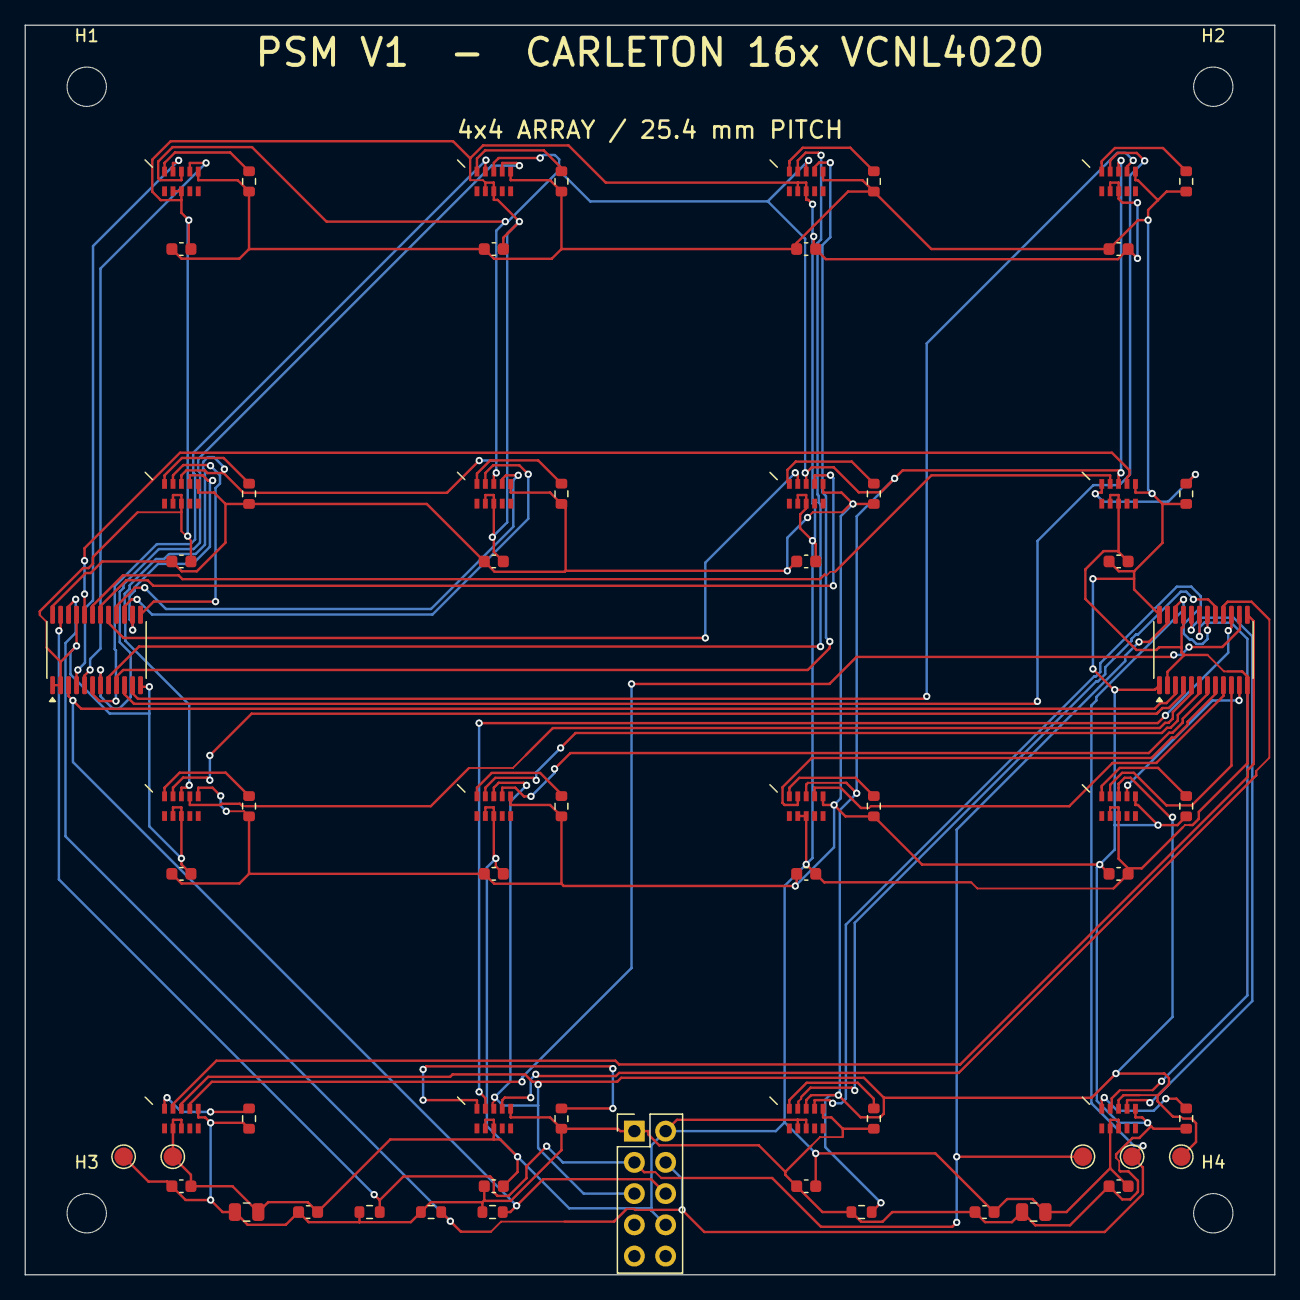
[picture p22: board psm-v1.kicad_pcb from above]

Board: 2 copper layers, 101.6 x 101.6 mm, 68 parts (0 on the bottom side), 54 nets.

Other parts of the board:
C19, C20: 100n; C_0603_1608Metric
H1, H2, H3, H4: M3; MountingHole_3.2mm_M3
TP1: 3V3; TestPoint_Pad_D1.5mm
TP2: GND; TestPoint_Pad_D1.5mm
TP3: SDA; TestPoint_Pad_D1.5mm
TP4: SCL; TestPoint_Pad_D1.5mm
TP5: INT_N; TestPoint_Pad_D1.5mm

Their connections:
3V3: C19.1, C20.1, TP1.1; also elsewhere on the board
GND: C19.2, C20.2, TP2.1; also elsewhere on the board
INT_N: TP5.1; also elsewhere on the board
SCL: TP4.1; also elsewhere on the board
SDA: TP3.1; also elsewhere on the board
