GurshanRiarh/INSTRUMENTED-INFANT-CHILD-CAR-SEAT/hardware/psm-v3/tile/psm-v3-tile.kicad_pcb

## KiCad design hardware/psm-v3/tile/psm-v3-tile.kicad_pcb (2026-10-25)

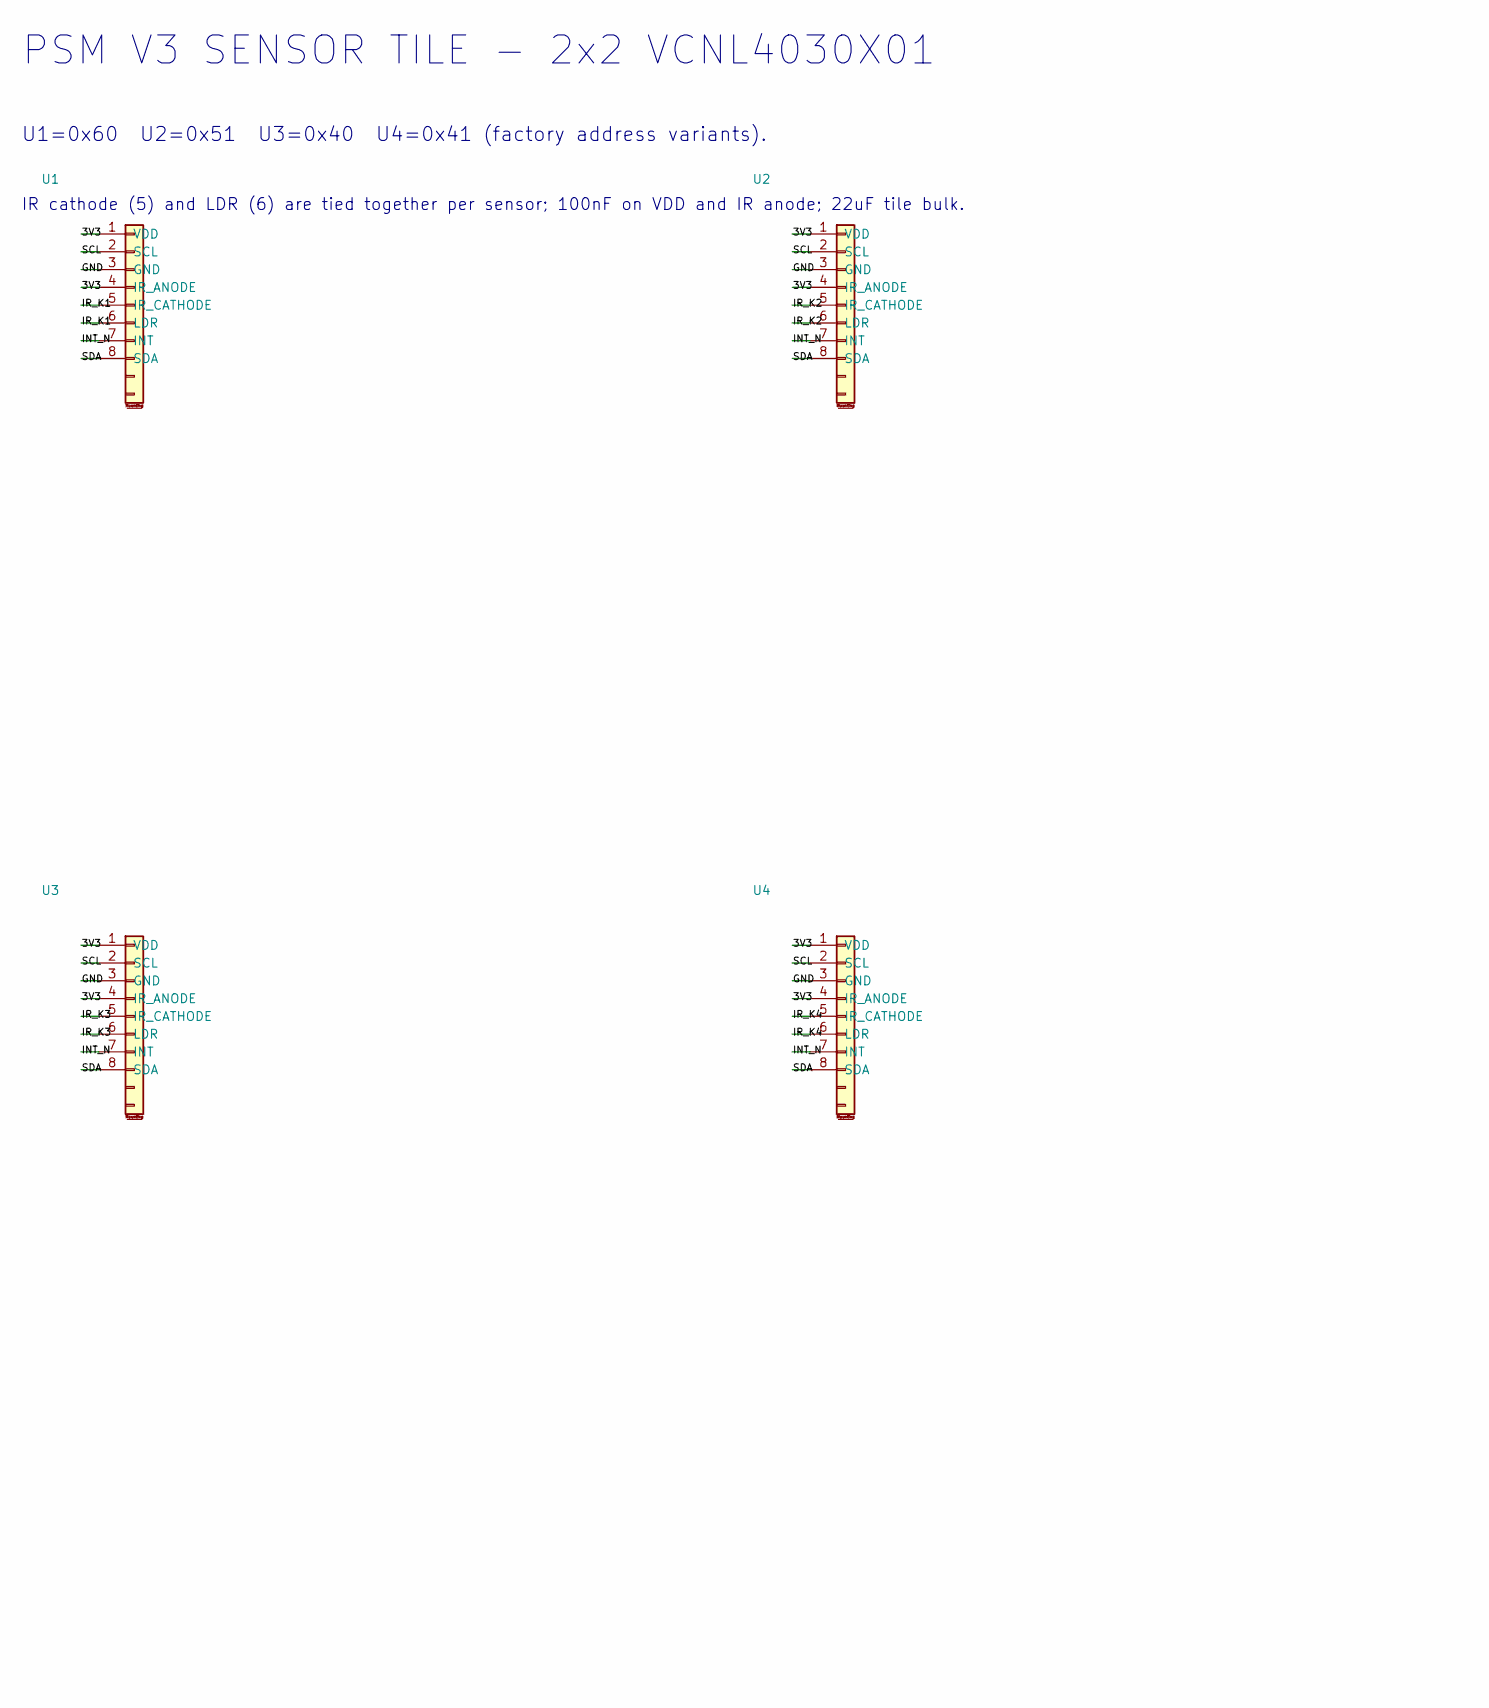
[picture p23: schematic psm-v3-tile.kicad_sch, PSM V3 Sensor Tile - Schematic, part in row 1, column 1]

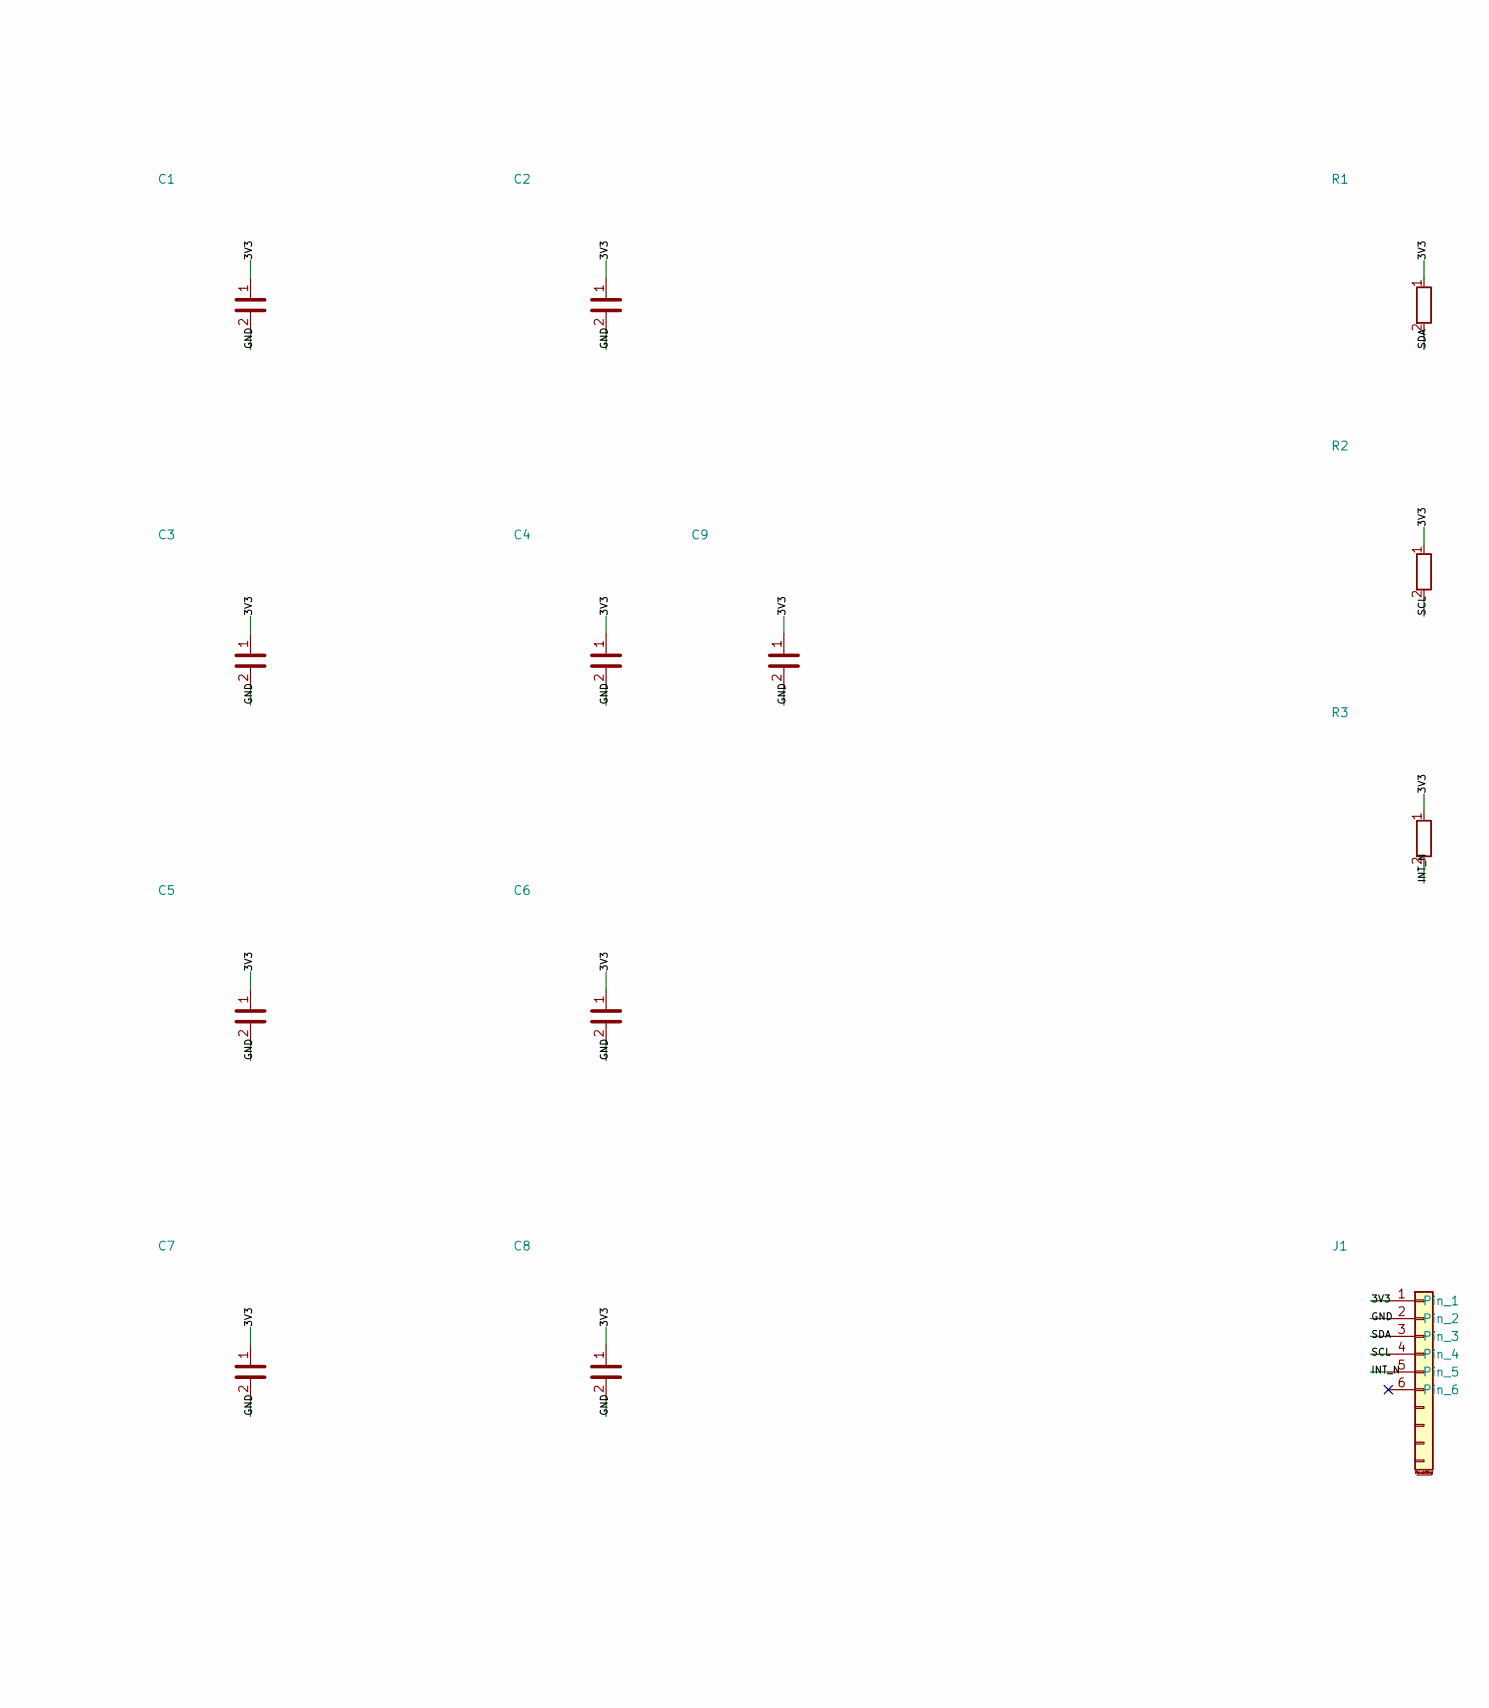
[picture p24: schematic psm-v3-tile.kicad_sch, PSM V3 Sensor Tile - Schematic, part in row 1, column 2]

Parts:
C1, C2, C3, C4, C5, C6, C7, C8: 100n; C_0603_1608Metric; Part Description 0.1uF 10% 16V Ceramic Capacitor X7R 040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
C9: 22u; C_0805_2012Metric; Part Description 0.1uF 10% 16V Ceramic Capacitor X7R 040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
J1: TILE_IF; PinHeader_1x06_P1.27mm_Vertical
R1, R2, R3: 10k; R_0603_1608Metric
U1: VCNL4030X01 0x60; VCNL4030X01
U2: VCNL4030X01 0x51; VCNL4030X01
U3: VCNL4030X01 0x40; VCNL4030X01
U4: VCNL4030X01 0x41; VCNL4030X01

Connections:
3V3: C1.1, C2.1, C3.1, C4.1, C5.1, C6.1, C7.1, C8.1, C9.1, J1.1, R1.1, R2.1, R3.1, U1.1 (VDD), U1.4 (IR_ANODE), U2.1 (VDD), U2.4 (IR_ANODE), U3.1 (VDD), U3.4 (IR_ANODE), U4.1 (VDD), U4.4 (IR_ANODE)
GND: C1.2, C2.2, C3.2, C4.2, C5.2, C6.2, C7.2, C8.2, C9.2, J1.2, U1.3 (GND), U2.3 (GND), U3.3 (GND), U4.3 (GND)
INT_N: J1.5, R3.2, U1.7 (INT), U2.7 (INT), U3.7 (INT), U4.7 (INT)
IR_K1: U1.5 (IR_CATHODE), U1.6 (LDR)
IR_K2: U2.5 (IR_CATHODE), U2.6 (LDR)
IR_K3: U3.5 (IR_CATHODE), U3.6 (LDR)
IR_K4: U4.5 (IR_CATHODE), U4.6 (LDR)
SCL: J1.4, R2.2, U1.2 (SCL), U2.2 (SCL), U3.2 (SCL), U4.2 (SCL)
SDA: J1.3, R1.2, U1.8 (SDA), U2.8 (SDA), U3.8 (SDA), U4.8 (SDA)

Notes on the sheet:
PSM V3 SENSOR TILE - 2x2 VCNL4030X01
U1=0x60 U2=0x51 U3=0x40 U4=0x41 (factory address variants).
IR cathode (5) and LDR (6) are tied together per sensor; 100nF on VDD and IR anode; 22uF tile bulk.
J1: 1=3V3 2=GND 3=SDA 4=SCL 5=INT_N 6=NC. Sealing ring and conformal coat are PCB-level.

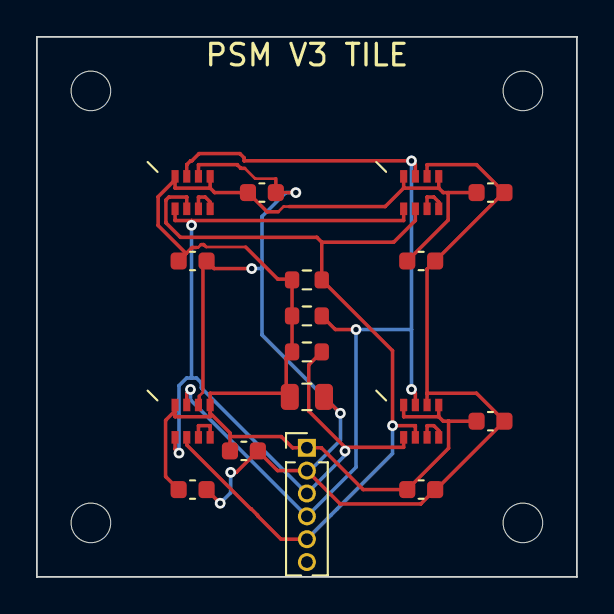
[picture p25: board psm-v3-tile.kicad_pcb from above]

Board: 2 copper layers, 30.0 x 30.0 mm, 21 parts (0 on the bottom side), 9 nets.

Other parts of the board:
H1, H2, H3, H4: M2; MountingHole_2.2mm_M2
