GurshanRiarh/INSTRUMENTED-INFANT-CHILD-CAR-SEAT/hardware/psm-v3/hub/psm-v3-hub.kicad_pcb

## KiCad design hardware/psm-v3/hub/psm-v3-hub.kicad_pcb (2026-10-25)

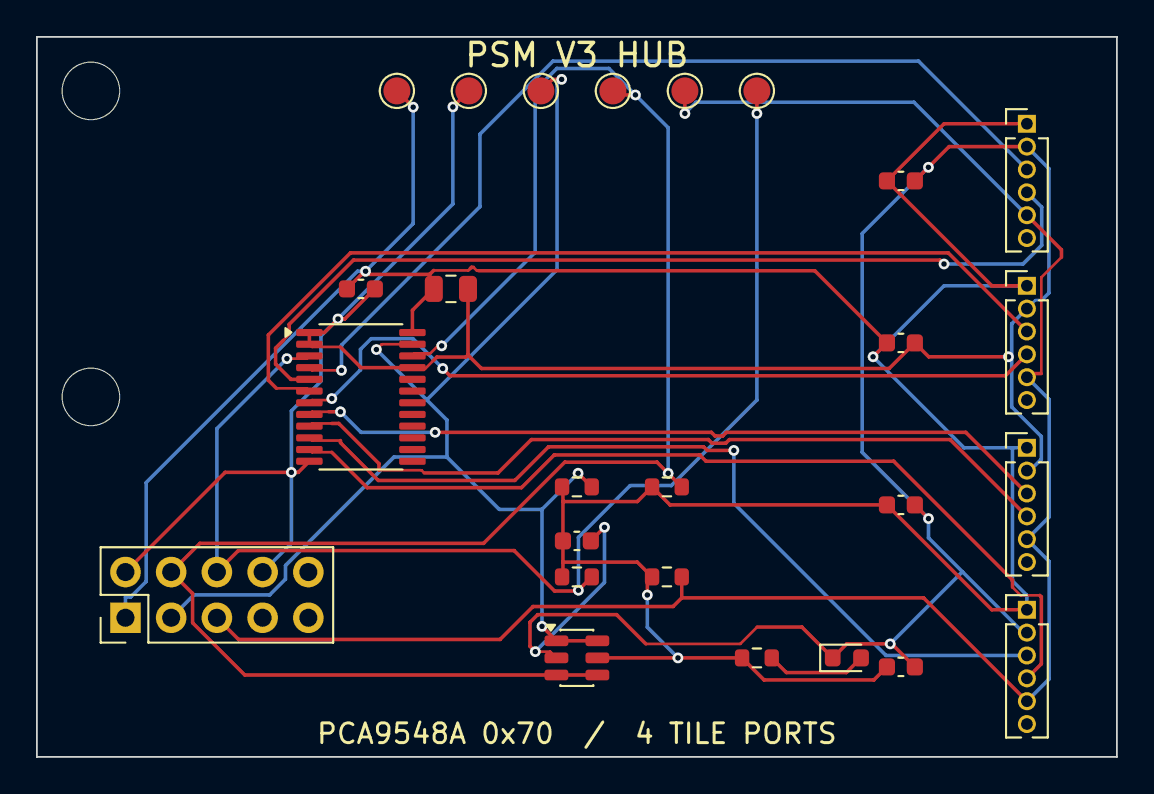
[picture p26: board psm-v3-hub.kicad_pcb from above]

Board: 2 copper layers, 60.0 x 40.0 mm, 28 parts (0 on the bottom side), 15 nets.

Parts:
C1, C3, C4, C5, C6, C7: 100n; C_0603_1608Metric
C2: 10u; C_0805_2012Metric
D1: POWER; LED_0603_1608Metric
H1, H2: M3; MountingHole_3.2mm_M3
J1: HOST_IF; PinHeader_2x05_P2.54mm_Vertical
J2: TILE_0; PinHeader_1x06_P1.27mm_Vertical
J3: TILE_1; PinHeader_1x06_P1.27mm_Vertical
J4: TILE_2; PinHeader_1x06_P1.27mm_Vertical
J5: TILE_3; PinHeader_1x06_P1.27mm_Vertical
R1, R2: 2.2k; R_0603_1608Metric
R3, R4: 10k; R_0603_1608Metric
R5: 1k; R_0603_1608Metric
TP1: 3V3; TestPoint_Pad_D1.5mm
TP2: GND; TestPoint_Pad_D1.5mm
TP3: SDA; TestPoint_Pad_D1.5mm
TP4: SCL; TestPoint_Pad_D1.5mm
TP5: INT_N; TestPoint_Pad_D1.5mm
TP6: MUX_RST; TestPoint_Pad_D1.5mm
U1: PCA9548A; TSSOP-24_4.4x7.8mm_P0.65mm
U2: USBLC6-2SC6; SOT-23-6

Connections:
3V3: C1.1, C2.1, C3.1, C4.1, C5.1, C6.1, C7.1, J1.1, J2.1, J3.1, J4.1, J5.1, R1.1, R2.1, R3.1, R4.1, R5.1, TP1.1, U1.24, U2.5
GND: C1.2, C2.2, C3.2, C4.2, C5.2, C6.2, C7.2, D1.1, J1.2, J1.8, J2.2, J3.2, J4.2, J5.2, TP2.1, U1.1, U1.2, U1.12, U1.21, U2.2
INT_N: J1.5, J2.5, J3.5, J4.5, J5.5, R4.2, TP5.1
LED_A: D1.2, R5.2
MUX_RST: J1.6, R3.2, TP6.1, U1.3
SCL: J1.4, R2.2, TP4.1, U1.22, U2.3, U2.4
SCL_C0: J2.4, U1.5
SCL_C1: J3.4, U1.7
SCL_C2: J4.4, U1.9
SCL_C3: J5.4, U1.11
SDA: J1.3, R1.2, TP3.1, U1.23, U2.1, U2.6
SDA_C0: J2.3, U1.4
SDA_C1: J3.3, U1.6
SDA_C2: J4.3, U1.8
SDA_C3: J5.3, U1.10
