GurshanRiarh/INSTRUMENTED-INFANT-CHILD-CAR-SEAT/(commit log)

2026-10-25 Add PSM V1 thesis-baseline KiCad design
    [bom.csv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]
2026-10-25 Add PSM V3 modular tile and hub with VCNL4030X01
    [bom.csv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]
2026-10-25 Add documentation, BOM, validation, and bring-up tooling
    [tile_mold.scad]
2026-10-25 Add full V1 and V3 KiCad schematics and netlist checks
    [psm-v1-B_Cu.gbl, psm-v1-B_Mask.gbs, psm-v1-Edge_Cuts.gm1, psm-v1-F_Cu.gtl, psm-v1-F_Mask.gts, psm-v1-F_Silkscreen.gto, psm-v1-NPTH.drl, psm-v1-PTH.drl]
2026-10-25 Add interactive self-contained board viewer
2026-10-25 Add approximate 3D models and renders to the board viewer
    [psm-v1.kicad_pcb, psm-v3-tile.kicad_pcb]
2026-10-25 Update README for full schematics and 3D viewer
