GurshanRiarh/INSTRUMENTED-INFANT-CHILD-CAR-SEAT/(notices)

Notices in the files:
parts and their libraries:
License: Apache-2.0
